Modos-Labs/Glider/assets/color_4bpp_ed.png

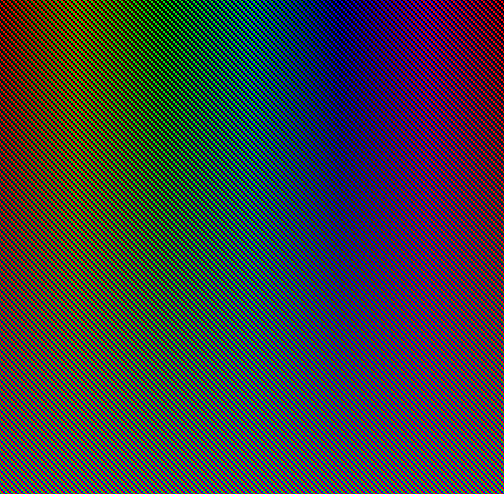
assets/color_4bpp_ed.png
