Modos-Labs/Glider/assets/color_8bpp.png

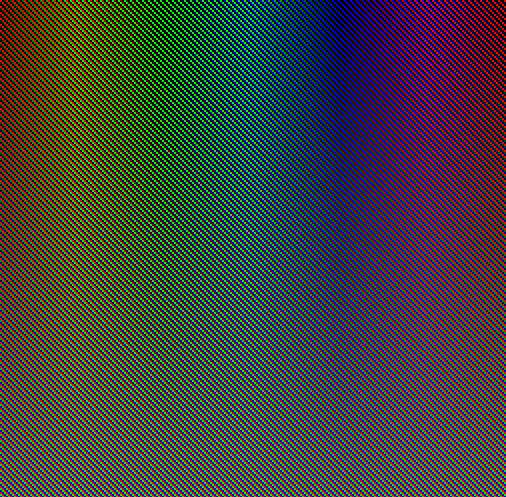
assets/color_8bpp.png
