Modos-Labs/Glider/assets/color_bayer.png

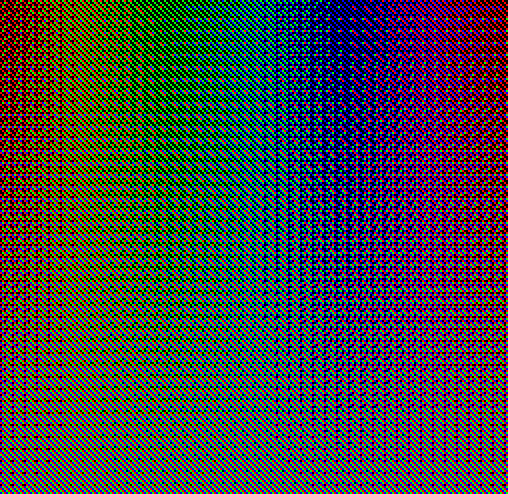
assets/color_bayer.png
