Modos-Labs/Glider/assets/color_des.jpg

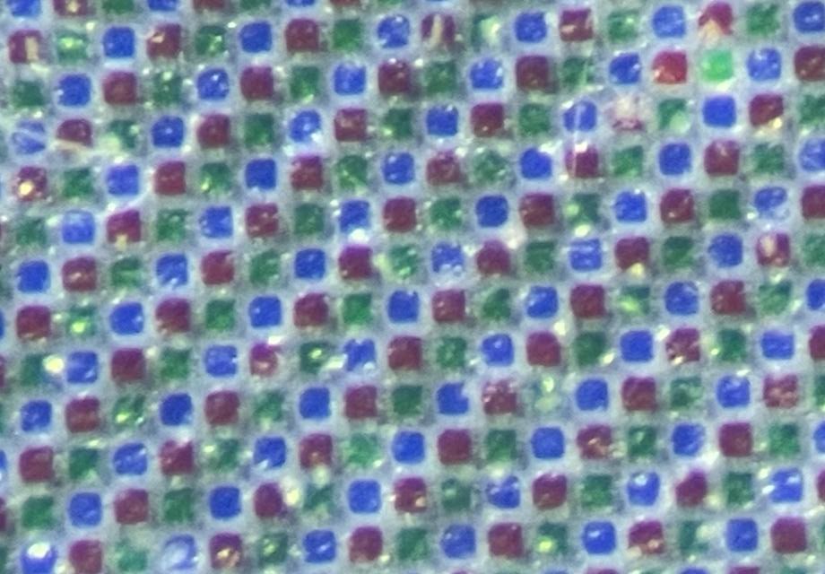
assets/color_des.jpg
