Modos-Labs/Glider/assets/color_fs_wrong.png

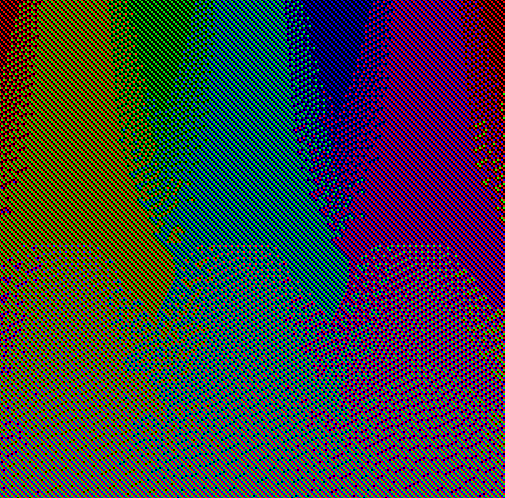
assets/color_fs_wrong.png
