Modos-Labs/Glider/assets/color_nd.png

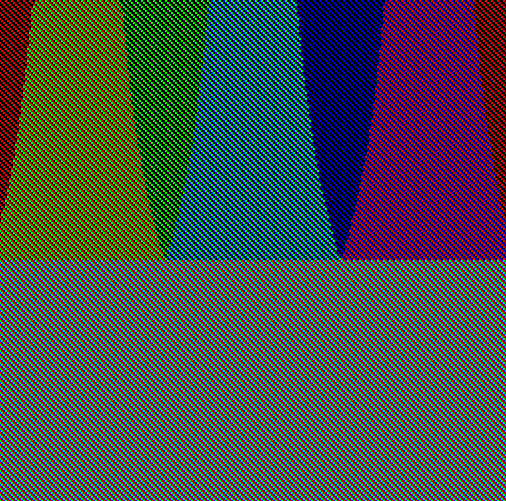
assets/color_nd.png
