Modos-Labs/Glider/assets/des_with_spr.png

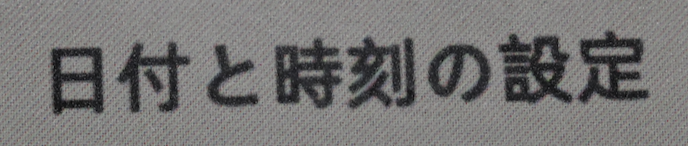
assets/des_with_spr.png
