Modos-Labs/Glider/assets/des_without_spr.png

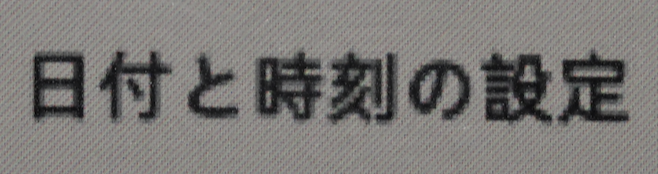
assets/des_without_spr.png
