Modos-Labs/Glider/assets/dither_gamma.jpg

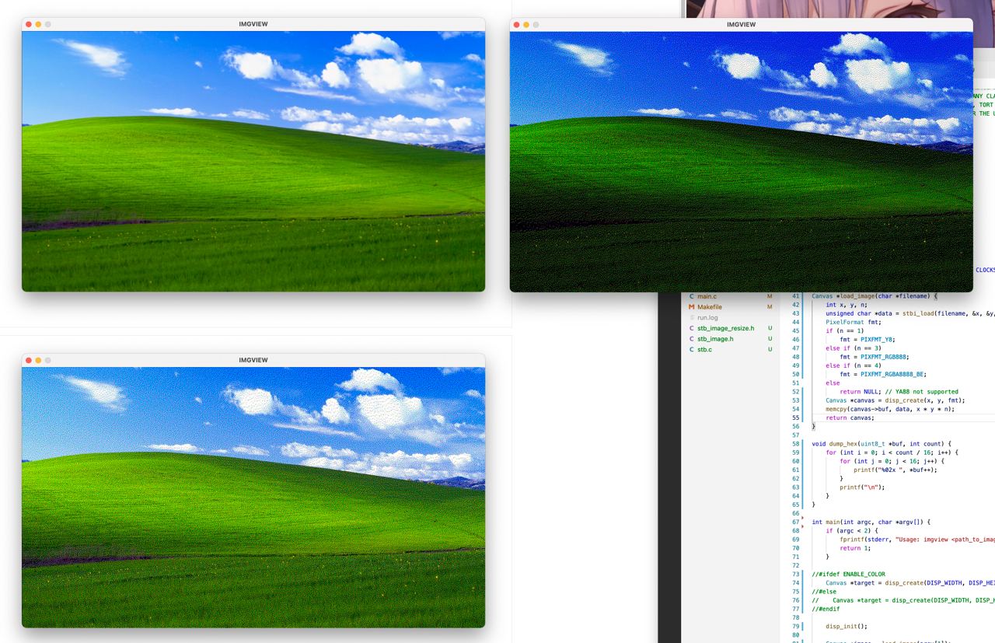
assets/dither_gamma.jpg
