Modos-Labs/Glider/assets/eink_16g.jpg

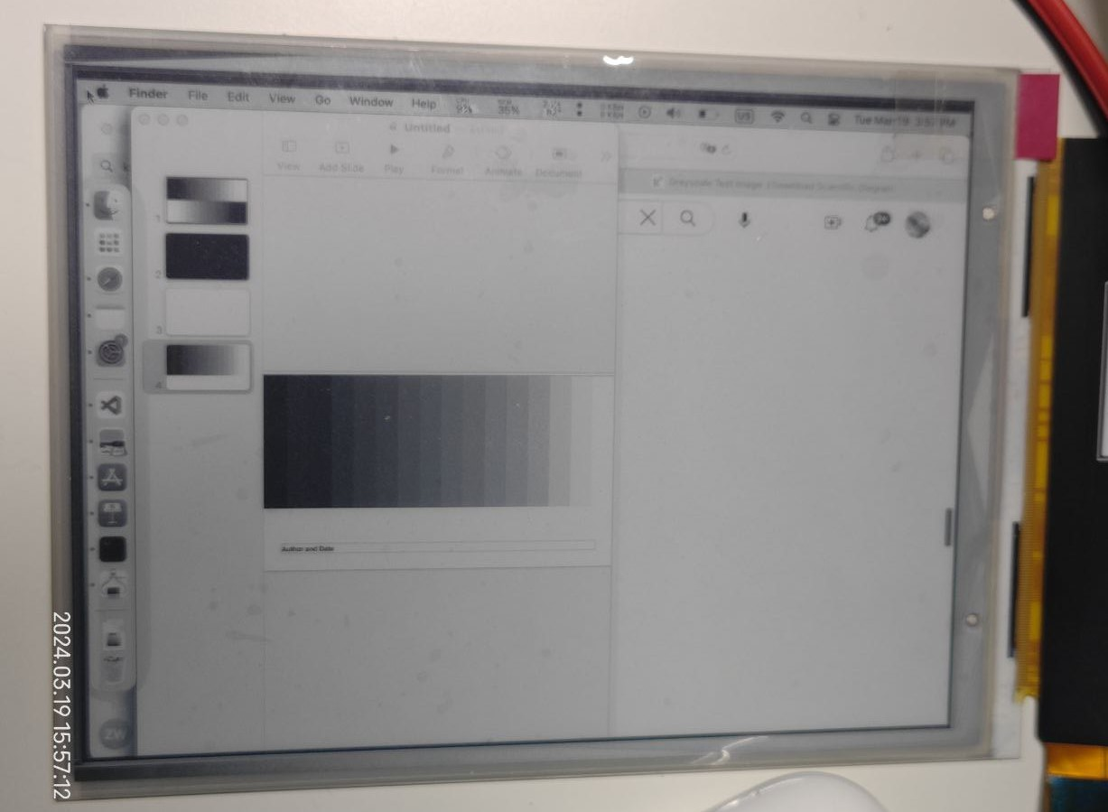
assets/eink_16g.jpg
