Modos-Labs/Glider/assets/eink_32g.jpg

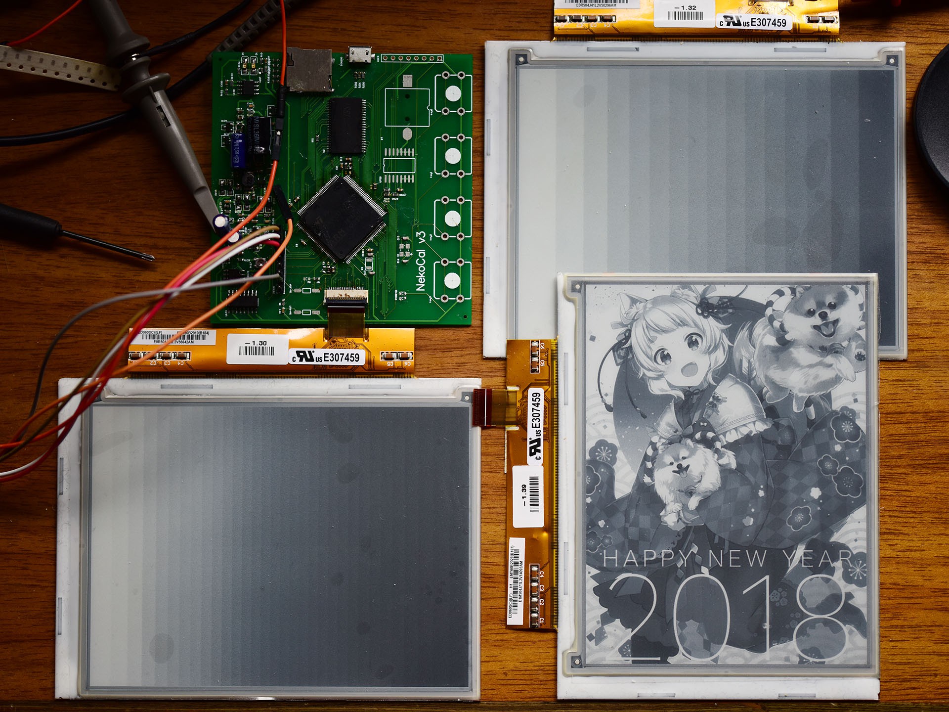
assets/eink_32g.jpg
