Modos-Labs/Glider/assets/eink_microscope.jpg

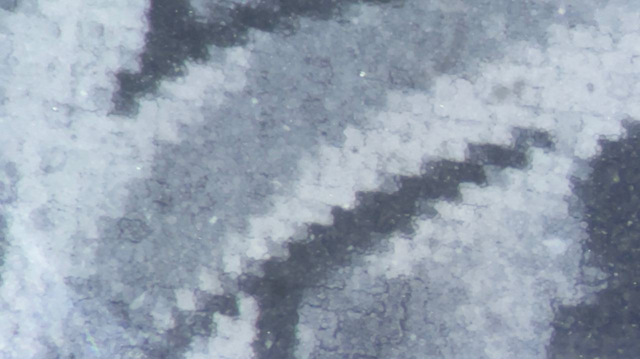
assets/eink_microscope.jpg
