Modos-Labs/Glider/assets/eink_serial.jpg

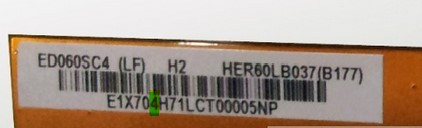
assets/eink_serial.jpg
