Modos-Labs/Glider/assets/eink_spectra6.jpg

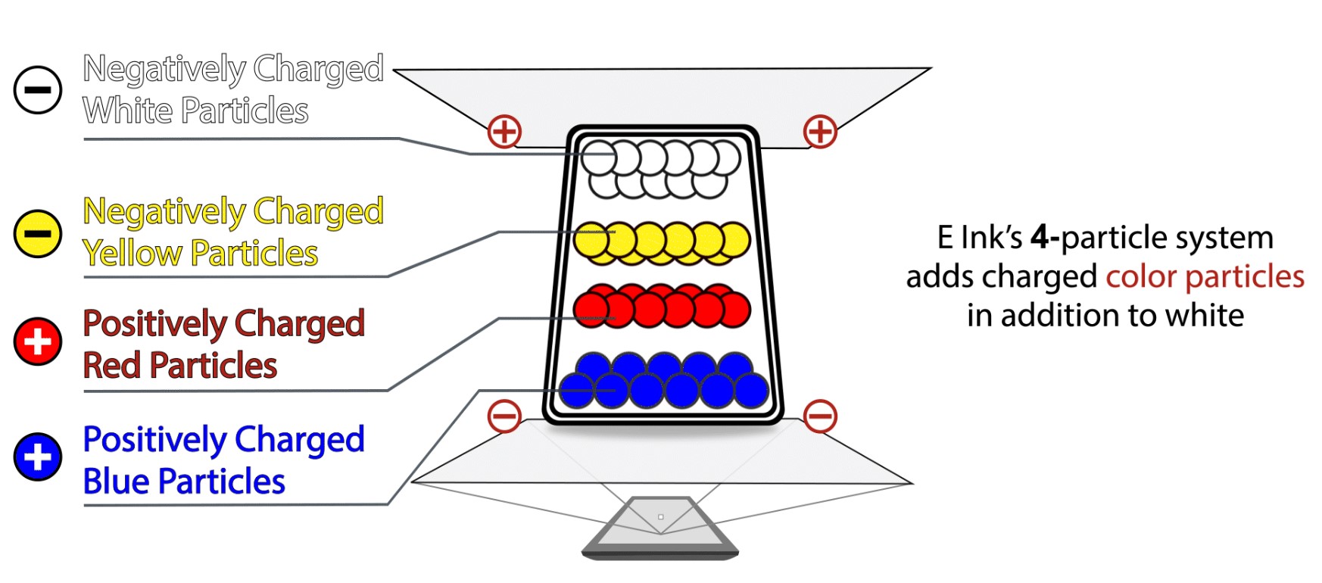
assets/eink_spectra6.jpg
