Modos-Labs/Glider/assets/gallery3_gallerypalette.jpg

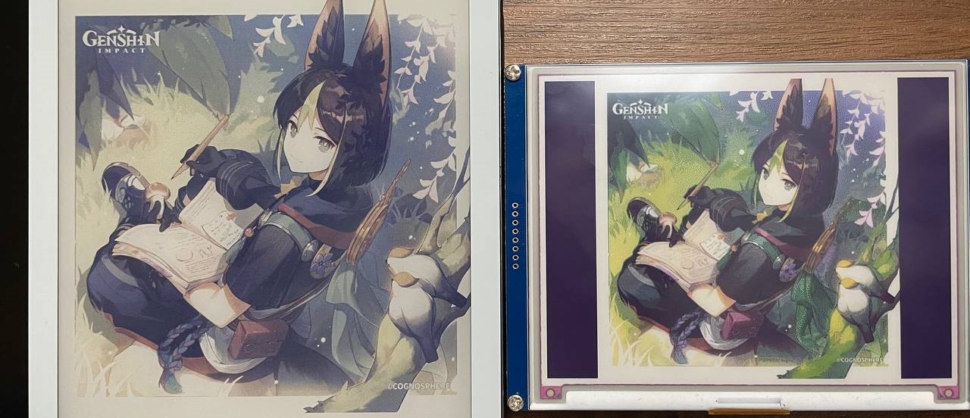
assets/gallery3_gallerypalette.jpg
