Modos-Labs/Glider/assets/gallery3_kaleido_plus.jpg

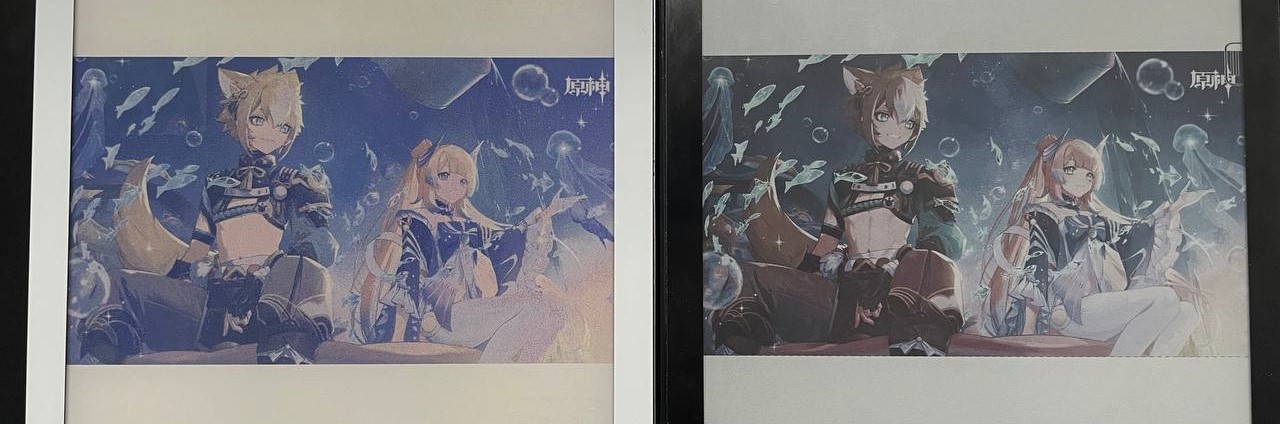
assets/gallery3_kaleido_plus.jpg
