Modos-Labs/Glider/assets/grad_4bpp_ed.png

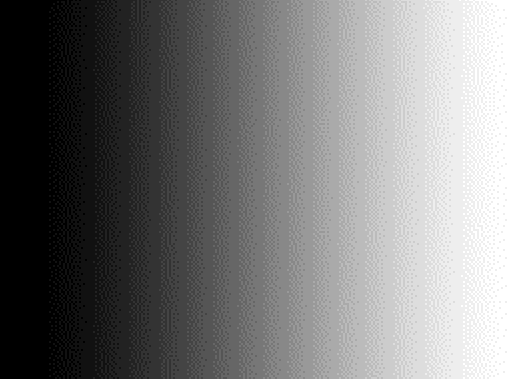
assets/grad_4bpp_ed.png
