Modos-Labs/Glider/assets/grad_no_dither.png

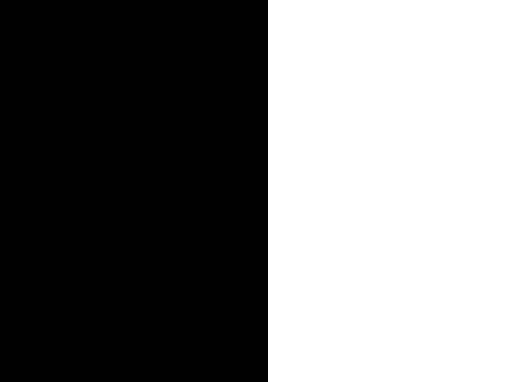
assets/grad_no_dither.png
