Modos-Labs/Glider/assets/hw_with_screen.jpg

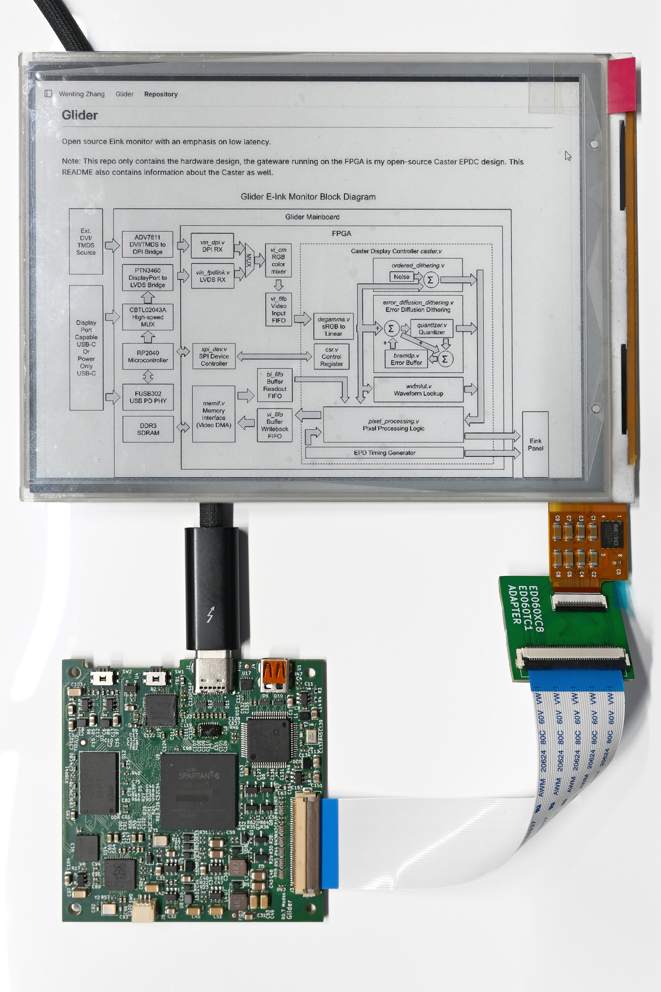
assets/hw_with_screen.jpg
