Modos-Labs/Glider/assets/isabella.jpg

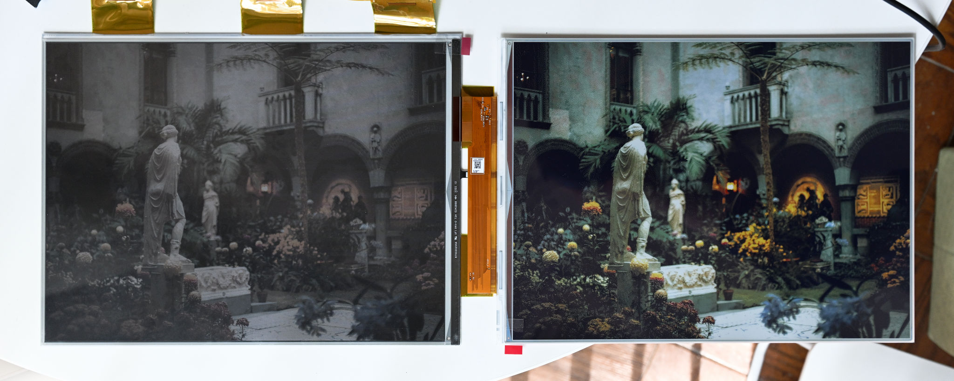
assets/isabella.jpg
