Modos-Labs/Glider/assets/kaleido3spectra6.jpg

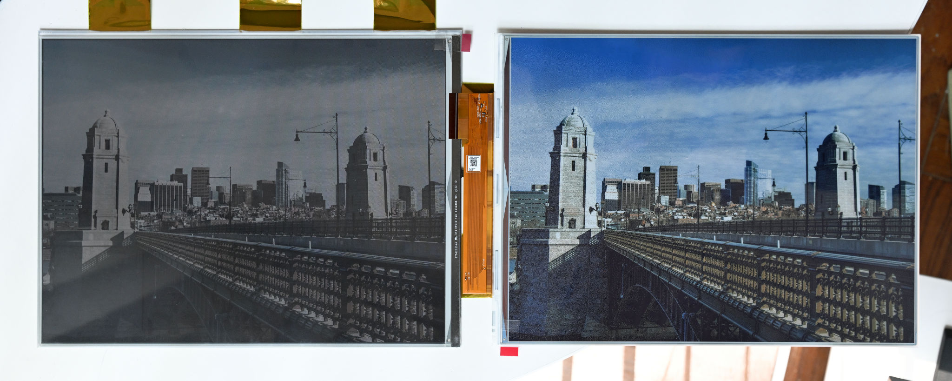
assets/kaleido3spectra6.jpg
