Modos-Labs/Glider/assets/PixelLayoutDiagonal.png

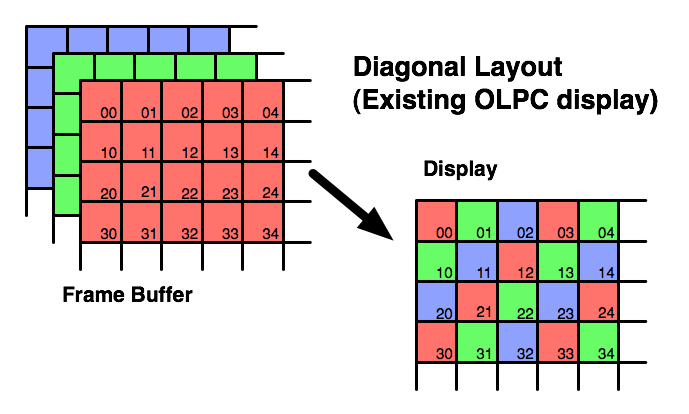
assets/PixelLayoutDiagonal.png
