Modos-Labs/Glider/assets/PixelProcDiagonal.png

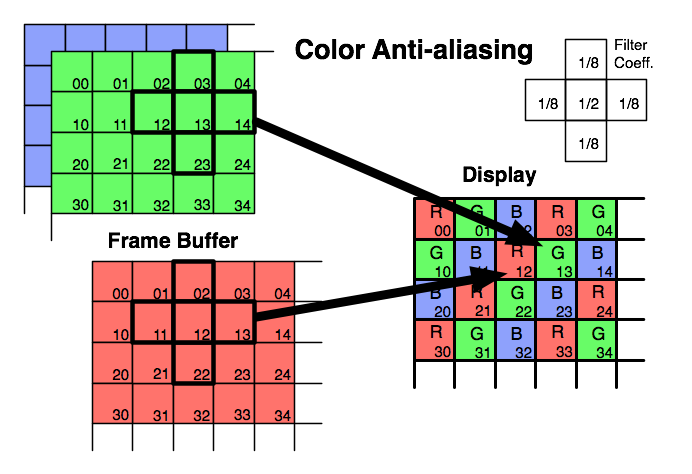
assets/PixelProcDiagonal.png
