Modos-Labs/Glider/assets/r0p7_mb.jpg

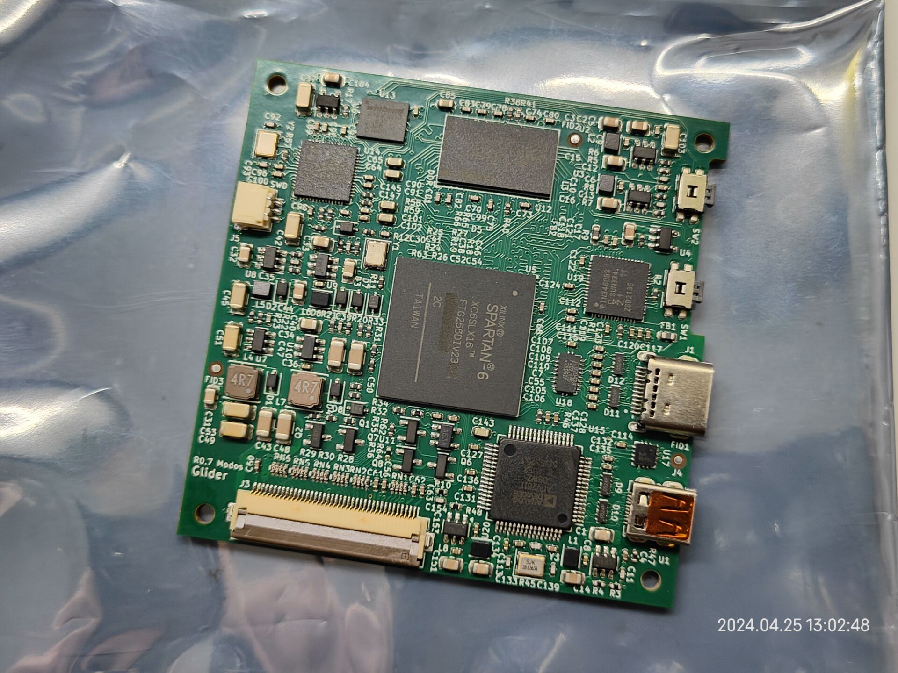
assets/r0p7_mb.jpg
