Modos-Labs/Glider/case/case.FCStd

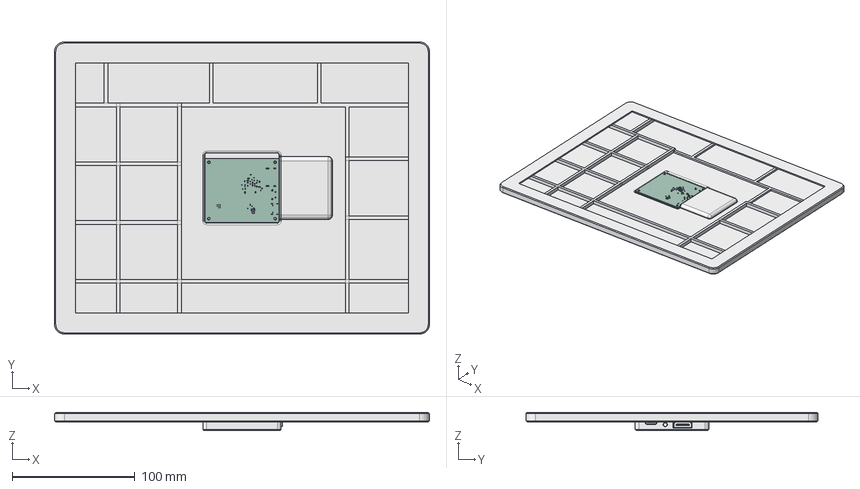
[picture p35: CAD file, 2024-01-24]
case/case.FCStd
306.0 x 238.4 x 15.0 mm
Front
Back
R_0402_1005Metric
R_0402_1005Metric002
R_0402_1005Metric004
C_0402_1005Metric
C_0402_1005Metric002
L_Wuerth_MAPI_2010
R_Array_Convex_4x0402
C_0402_1005Metric004
QFN-56-1EP_7x7mm_Pitch0.4mm
R_0402_1005Metric006
C_0805_2012Metric
L_Wuerth_MAPI_2011
TSOT_23_6
R_0402_1005Metric008
R_0402_1005Metric010
R_0402_1005Metric012
C_1206_3216Metric
C_1206_3216Metric002
C_0402_1005Metric006
C_0402_1005Metric008
C_0402_1005Metric010
C_0402_1005Metric012
C_0805_2012Metric002
C_0402_1005Metric014
C_0402_1005Metric016
R_0402_1005Metric014
C_0402_1005Metric018
SW_Tactile_SPST_Angled_PTS645Vx58-2LFS
WSON8-6x5
WSON8-6x006
WSON8-6x007
WSON8-6x008
WSON8-6x009
WSON8-6x010
WSON8-6x011
WSON8-6x012
WSON8-6x013
WSON8-6x014
D_SOD_323
C_0402_1005Metric020
SOT_23
C_0402_1005Metric022
R_0402_1005Metric016
C_0402_1005Metric024
D_SOD_324
C_0402_1005Metric026
R_0402_1005Metric018
L_Wuerth_MAPI_2012
C_0402_1005Metric028
C_0402_1005Metric030
C_0402_1005Metric032
C_0402_1005Metric034
SOT_024
TSOT_23_007
R_0402_1005Metric020
R_0402_1005Metric022
R_0402_1005Metric024
R_0402_1005Metric026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
