Modos-Labs/Glider/CHANGES.txt

The following are the changes for the hardware.

R0.1
1. Initial release.

R0.2
1. Switch from ECP5 to SPARTAN6 FPGA

R0.3
1. Remove on-board 39pin/ 50pin connector, switch to 40pin connector or EPD
2. Remove DSI input connector
3. Add DisplayPort to LVDS bridge chip and DisplayPort input

R0.4
1. Use Type-C input instead of full-size DisplayPort port

R0.5
1. Switch from MAX17135 PMIC to TPS65185 PMIC
2. Switch to a different TypeC connector model
3. Added global current limit

R0.6
1. Switch to individual DCDCs for Eink power supply

Lite R0.1
1. Use DVI TMDS input in place of Type-C input and DP bridge
2. Use DCDC instead of charge pump + zener diode for lower Iq
3. Add user button
4. Add VCOM measure capability
5. Add RP2040 SWD connector

R0.7
1. Import DVI TMDS input, newly revised power supply and user button from RL0.1
2. Connect FPGA to RP2040's hardware SPI
3. Fix USB Type C mux connection

R0.8
1. Fix DVI TMDS connector pinout
2. Add FL connector

R0.9
1. Switch to 7-series FPGA
2. New 50P connector for EPD
3. Add voltage/ current monitoring for the screen and the FPGA
4. Use FFC for FL connector
5. Add jumper for RP2040 ISP
6. Add shield

R0.10
1. Switch back to 6-series FPGA
2. Switch to use STM32H750 as EC

R0.11
1. Fix main DCDC feedback resistors
2. Adjust pinout assignment for EPD again

R0.12
1. Fix buttons
2. Fix DVI HPD connection

R0.13
1. Add user GPIOs
2. Use a lower profile USB receptacle

R1.0
1. Replace LGS5148 with LGS5145

R1.1
1. Fix DVI HPD glitch

R1.2
1. Add additional power switches for positive rails
2. Add additional decap for VCOM measurement
