Modos-Labs/Glider/pcb/mega_adapter/adapter.kicad_pcb

## KiCad design pcb/mega_adapter/adapter.kicad_pcb (2025-08-06)

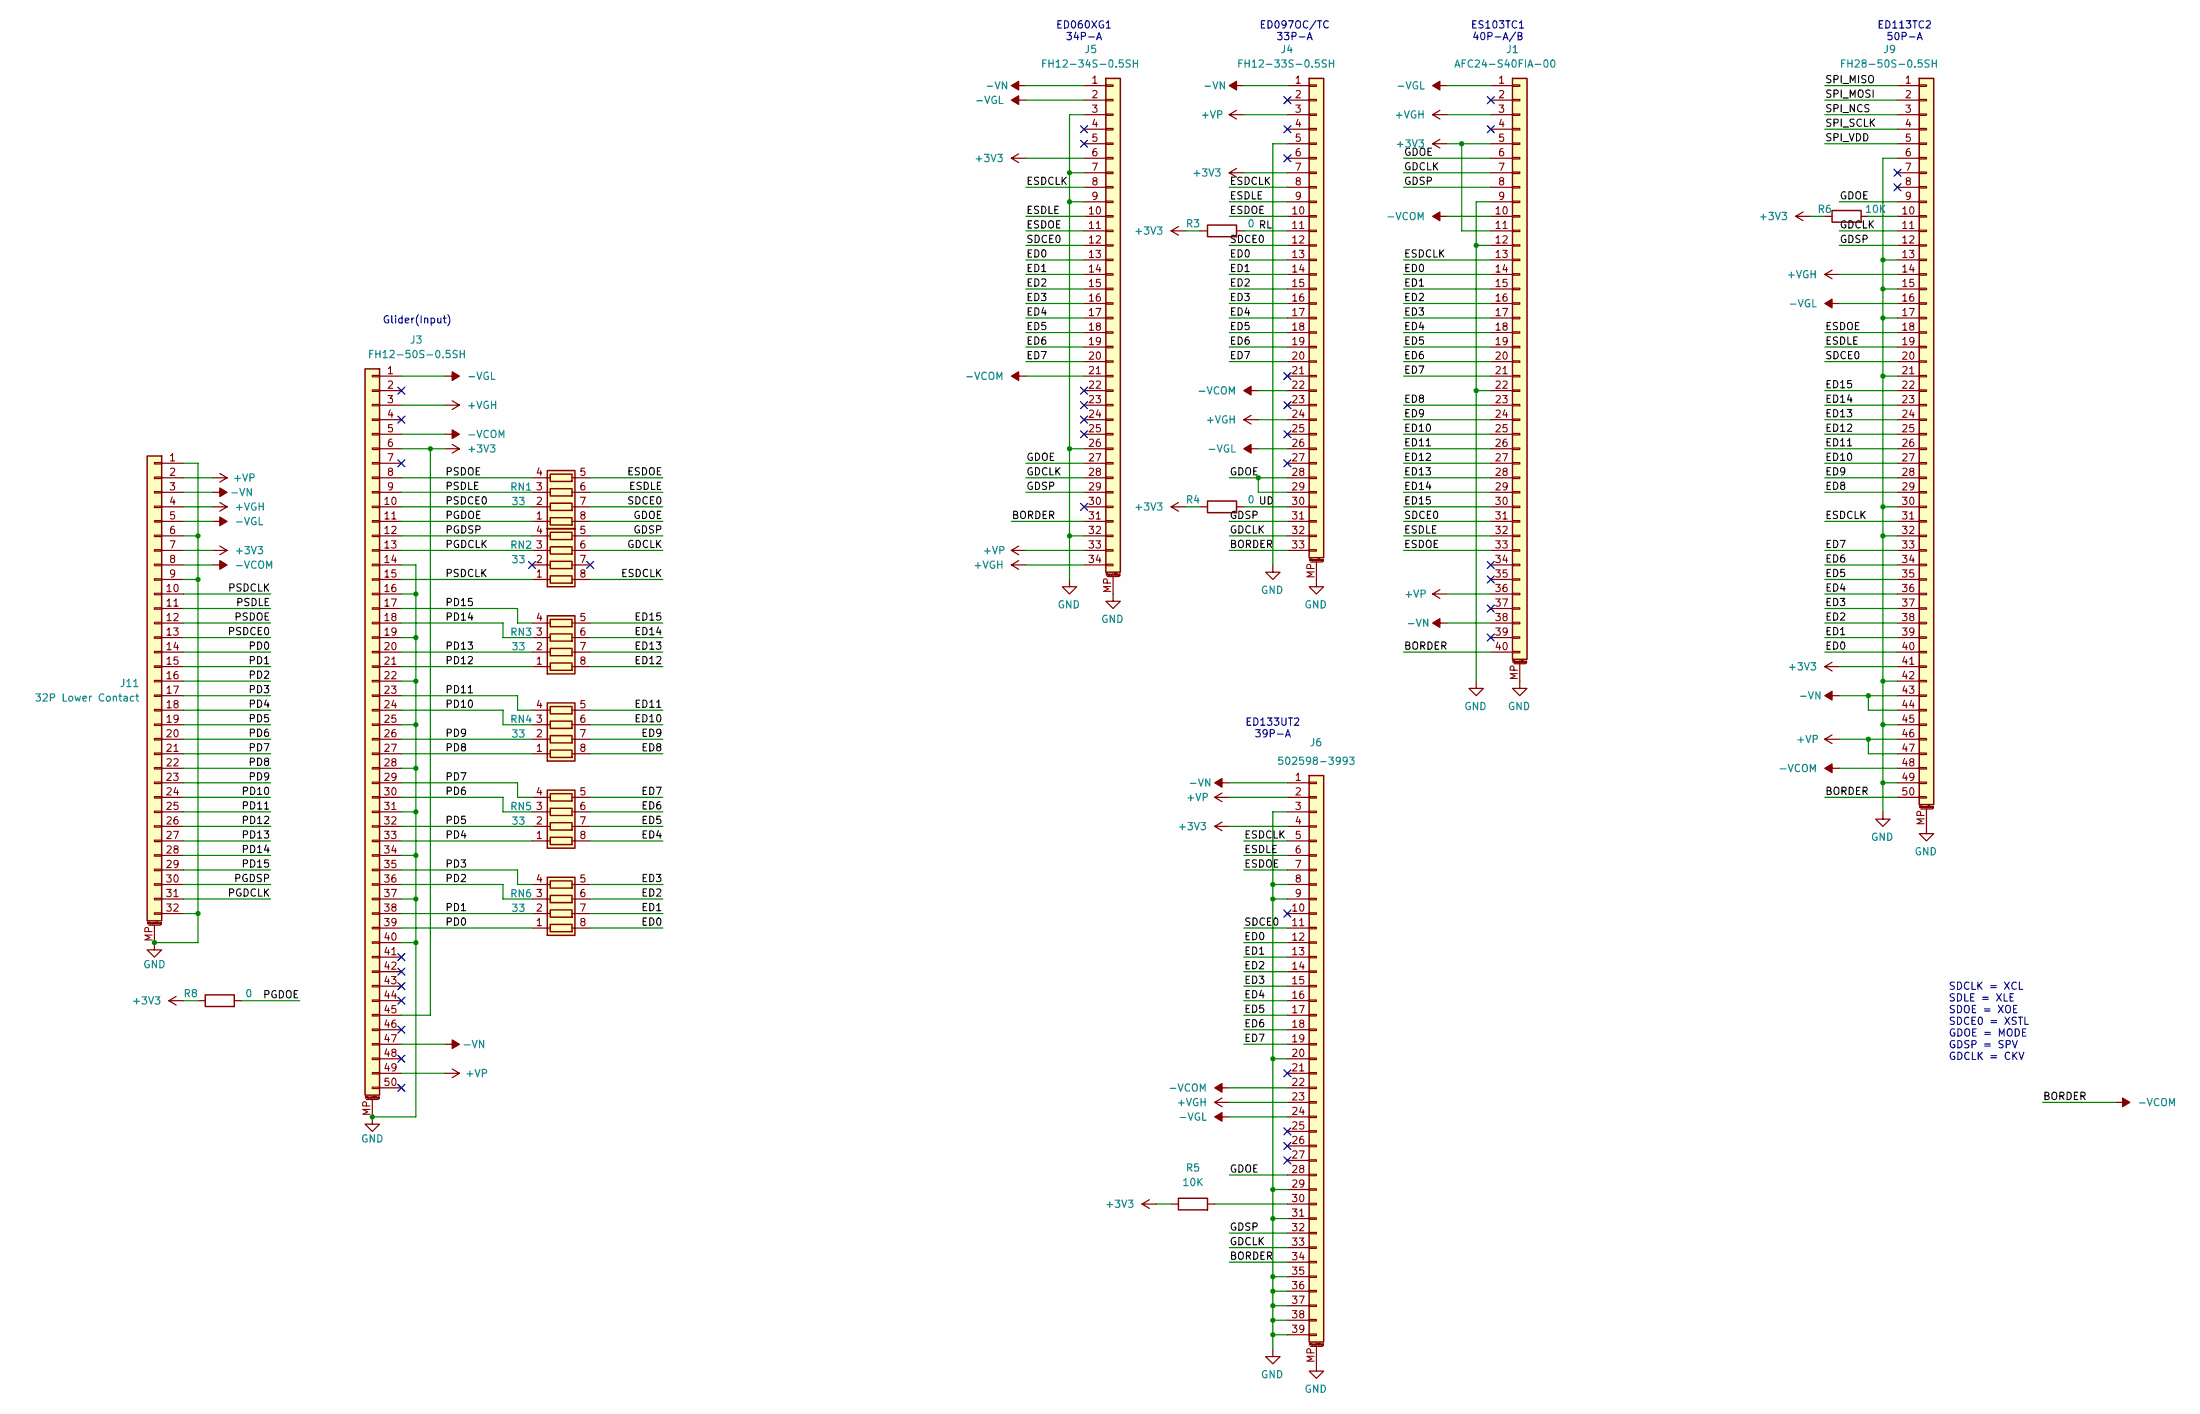
[picture p36: schematic adapter.kicad_sch]

Parts:
J1: AFC24-S40FIA-00; Omron_XF2M-4015-1A_1x40-1MP_P0.5mm_Horizontal
J3: FH12-50S-0.5SH; Hirose_FH12-50S-0.5SH_1x50-1MP_P0.50mm_Horizontal_Mirrored
J4: FH12-33S-0.5SH; Hirose_FH12-33S-0.5SH_1x33-1MP_P0.50mm_Horizontal
J5: FH12-34S-0.5SH; Hirose_FH12-34S-0.5SH_1x34-1MP_P0.50mm_Horizontal
J6: 502598-3993; Molex_5025983993; LCSC 609-10064555-392120HLFCT-ND
J9: FH28-50S-0.5SH; Hirose_FH12-50S-0.5SH_1x50-1MP_P0.50mm_Horizontal
J11: 32P Lower Contact; Hirose_FH12-32S-0.5SH_1x32-1MP_P0.50mm_Horizontal_Mirrored
R3, R4, R8: 0; R_0402_1005Metric
R5, R6: 10K; R_0402_1005Metric
RN1, RN2, RN3, RN4, RN5, RN6: 33; R_Array_Convex_4x0402

Connections:
+3V3: J1.5, J1.11, J3.6, J3.45, J4.7, J5.6, J6.4, J9.41, J11.7, R3.1, R4.1, R5.1, R6.1, R8.1
+VGH: J1.3, J3.3, J4.24, J5.34, J6.23, J9.14, J11.4
+VP: J1.36, J3.49, J4.3, J5.33, J6.2, J9.46, J9.47, J11.2
-VCOM: J1.10, J1.40, J3.5, J4.22, J4.33, J5.21, J5.31, J6.22, J6.34, J9.48, J9.50, J11.8
-VGL: J1.1, J3.1, J4.26, J5.2, J6.24, J9.16, J11.5
-VN: J1.38, J3.47, J4.1, J5.1, J6.1, J9.43, J9.44, J11.3
/ED0: J1.14, J4.13, J5.13, J6.12, J9.40, RN6.8 (R1.2)
/ED1: J1.15, J4.14, J5.14, J6.13, J9.39, RN6.7 (R2.2)
/ED2: J1.16, J4.15, J5.15, J6.14, J9.38, RN6.6 (R3.2)
/ED3: J1.17, J4.16, J5.16, J6.15, J9.37, RN6.5 (R4.2)
/ED4: J1.18, J4.17, J5.17, J6.16, J9.36, RN5.8 (R1.2)
/ED5: J1.19, J4.18, J5.18, J6.17, J9.35, RN5.7 (R2.2)
/ED6: J1.20, J4.19, J5.19, J6.18, J9.34, RN5.6 (R3.2)
/ED7: J1.21, J4.20, J5.20, J6.19, J9.33, RN5.5 (R4.2)
/ED8: J1.23, J9.29, RN4.8 (R1.2)
/ED9: J1.24, J9.28, RN4.7 (R2.2)
/ED10: J1.25, J9.27, RN4.6 (R3.2)
/ED11: J1.26, J9.26, RN4.5 (R4.2)
/ED12: J1.27, J9.25, RN3.8 (R1.2)
/ED13: J1.28, J9.24, RN3.7 (R2.2)
/ED14: J1.29, J9.23, RN3.6 (R3.2)
/ED15: J1.30, J9.22, RN3.5 (R4.2)
/ESDCLK: J1.13, J4.8, J5.8, J6.5, J9.31, RN2.8 (R1.2)
/ESDLE: J1.32, J4.9, J5.10, J6.6, J9.19, RN1.6 (R3.2)
/ESDOE: J1.33, J4.10, J5.11, J6.7, J9.18, RN1.5 (R4.2)
/GDCLK: J1.7, J4.32, J5.28, J6.33, J9.11, RN2.6 (R3.2)
/GDOE: J1.6, J4.28, J4.29, J5.27, J6.28, J9.9, RN1.8 (R1.2)
/GDSP: J1.8, J4.31, J5.29, J6.32, J9.12, RN2.5 (R4.2)
/PD0: J3.39, J11.14, RN6.1 (R1.1)
/PD1: J3.38, J11.15, RN6.2 (R2.1)
/PD2: J3.36, J11.16, RN6.3 (R3.1)
/PD3: J3.35, J11.17, RN6.4 (R4.1)
/PD4: J3.33, J11.18, RN5.1 (R1.1)
/PD5: J3.32, J11.19, RN5.2 (R2.1)
/PD6: J3.30, J11.20, RN5.3 (R3.1)
/PD7: J3.29, J11.21, RN5.4 (R4.1)
/PD8: J3.27, J11.22, RN4.1 (R1.1)
/PD9: J3.26, J11.23, RN4.2 (R2.1)
/PD10: J3.24, J11.24, RN4.3 (R3.1)
/PD11: J3.23, J11.25, RN4.4 (R4.1)
/PD12: J3.21, J11.26, RN3.1 (R1.1)
/PD13: J3.20, J11.27, RN3.2 (R2.1)
/PD14: J3.18, J11.28, RN3.3 (R3.1)
/PD15: J3.17, J11.29, RN3.4 (R4.1)
/PGDCLK: J3.13, J11.31, RN2.3 (R3.1)
/PGDOE: J3.11, R8.2, RN1.1 (R1.1)
/PGDSP: J3.12, J11.30, RN2.4 (R4.1)
/PSDCE0: J3.10, J11.13, RN1.2 (R2.1)
/PSDCLK: J3.15, J11.10, RN2.1 (R1.1)
/PSDLE: J3.9, J11.11, RN1.3 (R3.1)
/PSDOE: J3.8, J11.12, RN1.4 (R4.1)
/RL: J4.11, R3.2
/SDCE0: J1.31, J4.12, J5.12, J6.11, J9.20, RN1.7 (R2.2)
/SPI_MISO: J9.1
/SPI_MOSI: J9.2
/SPI_NCS: J9.3
/SPI_SCLK: J9.4
/SPI_VDD: J9.5
/UD: J4.30, R4.2
GND: J1.9, J1.12, J1.22, J1.MP (MountPin), J3.14, J3.16, J3.19, J3.22, J3.25, J3.28, J3.31, J3.34, J3.37, J3.40, J3.MP (MountPin), J4.5, J4.MP (MountPin), J5.3, J5.7, J5.9, J5.26, J5.32, J5.MP (MountPin), J6.3, J6.8, J6.9, J6.20, J6.29, J6.31, J6.35, J6.36, J6.37, J6.38, J6.39, J6.MP (MountPin), J9.6, J9.13, J9.15, J9.17, J9.21, J9.30, J9.32, J9.42, J9.45, J9.49, J9.MP (MountPin), J11.1, J11.6, J11.9, J11.32, J11.MP (MountPin)
unnamed: J6.30, R5.2
unnamed: J9.10, R6.2

Notes on the sheet:
ED133UT2 39P-A
ED060XG1 34P-A
ED113TC2 50P-A
Glider(Input)
ES103TC1 40P-A/B
ED097OC/TC 33P-A
SDCLK = XCL SDLE = XLE SDOE = XOE SDCE0 = XSTL GDOE = MODE GDSP = SPV GDCLK = CKV

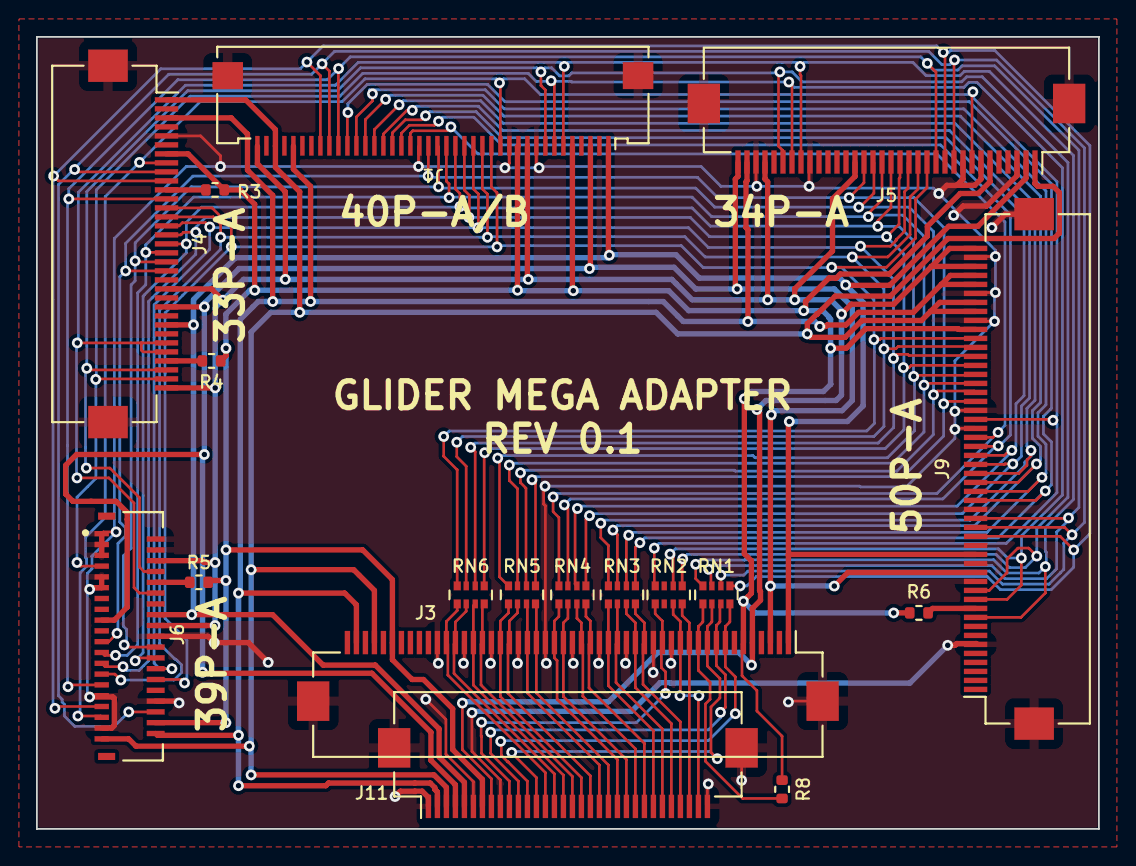
[picture p37: board pcb/mega_adapter/adapter.kicad_pcb from above]

Board: 2 copper layers, 59.0 x 44.0 mm, 18 parts (0 on the bottom side), 57 nets.
