Modos-Labs/Glider/pcb/34p-adapter-a/adapter.kicad_pcb

## KiCad design pcb/34p-adapter-a/adapter.kicad_pcb (2025-08-06)

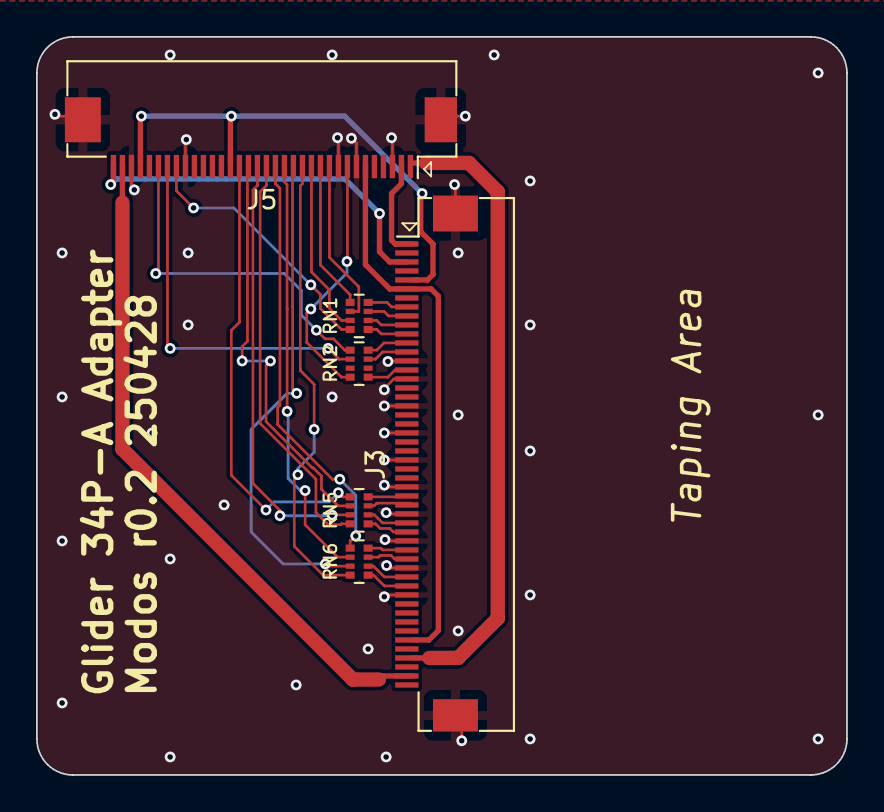
[picture p38: board pcb/34p-adapter-a/adapter.kicad_pcb from above]

Board: 2 copper layers, 45.0 x 41.0 mm, 6 parts (0 on the bottom side), 37 nets.

Parts:
J3: FH12-50S-0.5SH; Xunpu_FPC-05F-50PH20_1x50-1MP_P0.50mm_Horizontal_Mirrored
J5: FH12-34S-0.5SH; Xunpu_FPC-05F-34PH20_1x34-1MP_P0.50mm_Horizontal
RN1, RN2, RN5, RN6: 33; R_Array_Convex_4x0402

Connections:
+3V3: J3.6, J3.45, J5.6
+VGH: J3.3, J5.34
+VP: J3.49, J5.33
-VCOM: J3.5, J5.21, J5.31
-VGL: J3.1, J5.2
-VN: J3.47, J5.1
/ED0: J5.13, RN6.8 (R1.2)
/ED1: J5.14, RN6.7 (R2.2)
/ED2: J5.15, RN6.6 (R3.2)
/ED3: J5.16, RN6.5 (R4.2)
/ED4: J5.17, RN5.8 (R1.2)
/ED5: J5.18, RN5.7 (R2.2)
/ED6: J5.19, RN5.6 (R3.2)
/ED7: J5.20, RN5.5 (R4.2)
/ESDCLK: J5.8, RN2.8 (R1.2)
/ESDLE: J5.10, RN1.6 (R3.2)
/ESDOE: J5.11, RN1.5 (R4.2)
/GDCLK: J5.28, RN2.6 (R3.2)
/GDOE: J5.27, RN1.8 (R1.2)
/GDSP: J5.29, RN2.5 (R4.2)
/PD0: J3.39, RN6.1 (R1.1)
/PD1: J3.38, RN6.2 (R2.1)
/PD2: J3.36, RN6.3 (R3.1)
/PD3: J3.35, RN6.4 (R4.1)
/PD4: J3.33, RN5.1 (R1.1)
/PD5: J3.32, RN5.2 (R2.1)
/PD6: J3.30, RN5.3 (R3.1)
/PD7: J3.29, RN5.4 (R4.1)
/PGDCLK: J3.13, RN2.3 (R3.1)
/PGDOE: J3.11, RN1.1 (R1.1)
/PGDSP: J3.12, RN2.4 (R4.1)
/PSDCE0: J3.10, RN1.2 (R2.1)
/PSDCLK: J3.15, RN2.1 (R1.1)
/PSDLE: J3.9, RN1.3 (R3.1)
/PSDOE: J3.8, RN1.4 (R4.1)
/SDCE0: J5.12, RN1.7 (R2.2)
GND: J3.14, J3.16, J3.19, J3.22, J3.25, J3.28, J3.31, J3.34, J3.37, J3.40, J3.MP (MountPin), J5.3, J5.7, J5.9, J5.26, J5.32, J5.MP (MountPin)
