Modos-Labs/Glider/pcb/40p-adapter-ab/adapter.kicad_pcb

## KiCad design pcb/40p-adapter-ab/adapter.kicad_pcb (2025-08-06)

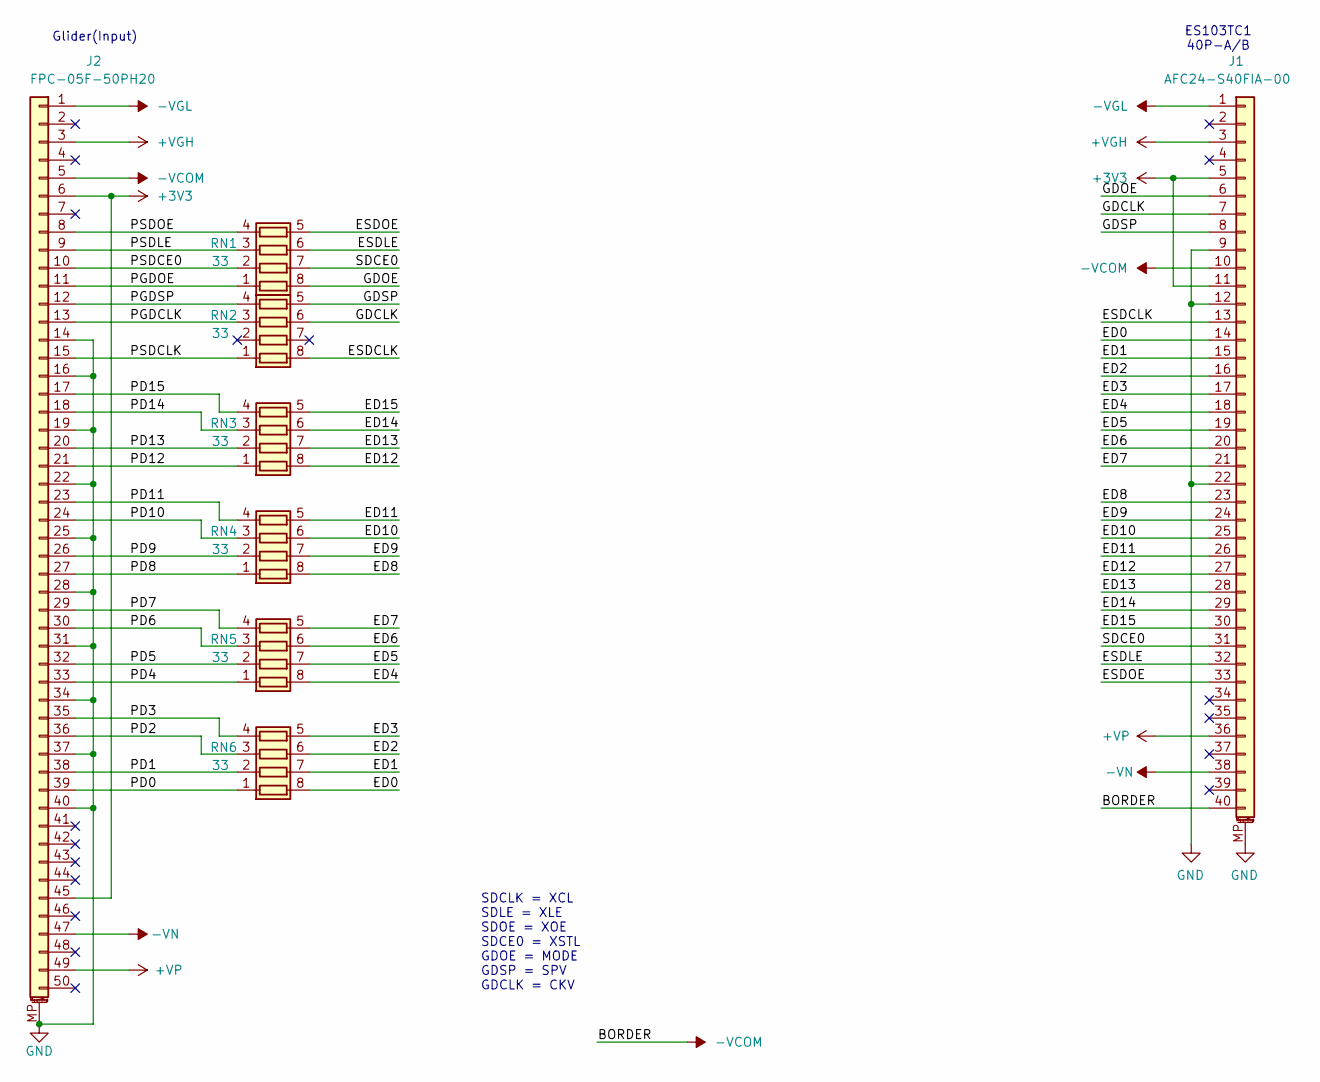
[picture p39: schematic adapter.kicad_sch]

Parts:
J1: AFC24-S40FIA-00; Omron_XF2M-4015-1A_1x40-1MP_P0.5mm_Horizontal
J2: FPC-05F-50PH20; Xunpu_FPC-05F-50PH20_1x50-1MP_P0.50mm_Horizontal_Mirrored
RN1, RN2, RN3, RN4, RN5, RN6: 33; R_Array_Convex_4x0402

Connections:
+3V3: J1.5, J1.11, J2.6, J2.45
+VGH: J1.3, J2.3
+VP: J1.36, J2.49
-VCOM: J1.10, J1.40, J2.5
-VGL: J1.1, J2.1
-VN: J1.38, J2.47
/ED0: J1.14, RN6.8 (R1.2)
/ED1: J1.15, RN6.7 (R2.2)
/ED2: J1.16, RN6.6 (R3.2)
/ED3: J1.17, RN6.5 (R4.2)
/ED4: J1.18, RN5.8 (R1.2)
/ED5: J1.19, RN5.7 (R2.2)
/ED6: J1.20, RN5.6 (R3.2)
/ED7: J1.21, RN5.5 (R4.2)
/ED8: J1.23, RN4.8 (R1.2)
/ED9: J1.24, RN4.7 (R2.2)
/ED10: J1.25, RN4.6 (R3.2)
/ED11: J1.26, RN4.5 (R4.2)
/ED12: J1.27, RN3.8 (R1.2)
/ED13: J1.28, RN3.7 (R2.2)
/ED14: J1.29, RN3.6 (R3.2)
/ED15: J1.30, RN3.5 (R4.2)
/ESDCLK: J1.13, RN2.8 (R1.2)
/ESDLE: J1.32, RN1.6 (R3.2)
/ESDOE: J1.33, RN1.5 (R4.2)
/GDCLK: J1.7, RN2.6 (R3.2)
/GDOE: J1.6, RN1.8 (R1.2)
/GDSP: J1.8, RN2.5 (R4.2)
/PD0: J2.39, RN6.1 (R1.1)
/PD1: J2.38, RN6.2 (R2.1)
/PD2: J2.36, RN6.3 (R3.1)
/PD3: J2.35, RN6.4 (R4.1)
/PD4: J2.33, RN5.1 (R1.1)
/PD5: J2.32, RN5.2 (R2.1)
/PD6: J2.30, RN5.3 (R3.1)
/PD7: J2.29, RN5.4 (R4.1)
/PD8: J2.27, RN4.1 (R1.1)
/PD9: J2.26, RN4.2 (R2.1)
/PD10: J2.24, RN4.3 (R3.1)
/PD11: J2.23, RN4.4 (R4.1)
/PD12: J2.21, RN3.1 (R1.1)
/PD13: J2.20, RN3.2 (R2.1)
/PD14: J2.18, RN3.3 (R3.1)
/PD15: J2.17, RN3.4 (R4.1)
/PGDCLK: J2.13, RN2.3 (R3.1)
/PGDOE: J2.11, RN1.1 (R1.1)
/PGDSP: J2.12, RN2.4 (R4.1)
/PSDCE0: J2.10, RN1.2 (R2.1)
/PSDCLK: J2.15, RN2.1 (R1.1)
/PSDLE: J2.9, RN1.3 (R3.1)
/PSDOE: J2.8, RN1.4 (R4.1)
/SDCE0: J1.31, RN1.7 (R2.2)
GND: J1.9, J1.12, J1.22, J1.MP (MountPin), J2.14, J2.16, J2.19, J2.22, J2.25, J2.28, J2.31, J2.34, J2.37, J2.40, J2.MP (MountPin)

Notes on the sheet:
Glider(Input)
ES103TC1 40P-A/B
SDCLK = XCL SDLE = XLE SDOE = XOE SDCE0 = XSTL GDOE = MODE GDSP = SPV GDCLK = CKV

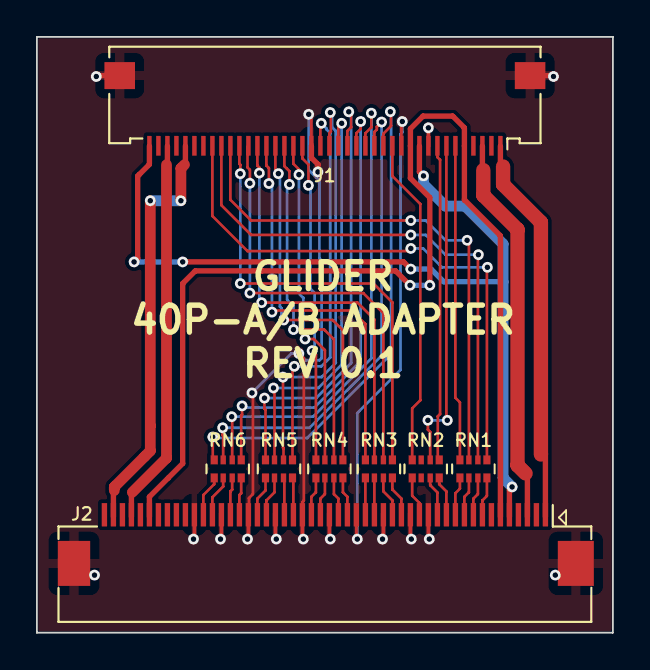
[picture p40: board pcb/40p-adapter-ab/adapter.kicad_pcb from above]

Board: 2 copper layers, 32.0 x 33.1 mm, 8 parts (0 on the bottom side), 53 nets.
