Modos-Labs/Glider/pcb/u133_adapter/adapter.kicad_pcb

## KiCad design pcb/u133_adapter/adapter.kicad_pcb (2025-07-13, an earlier design)

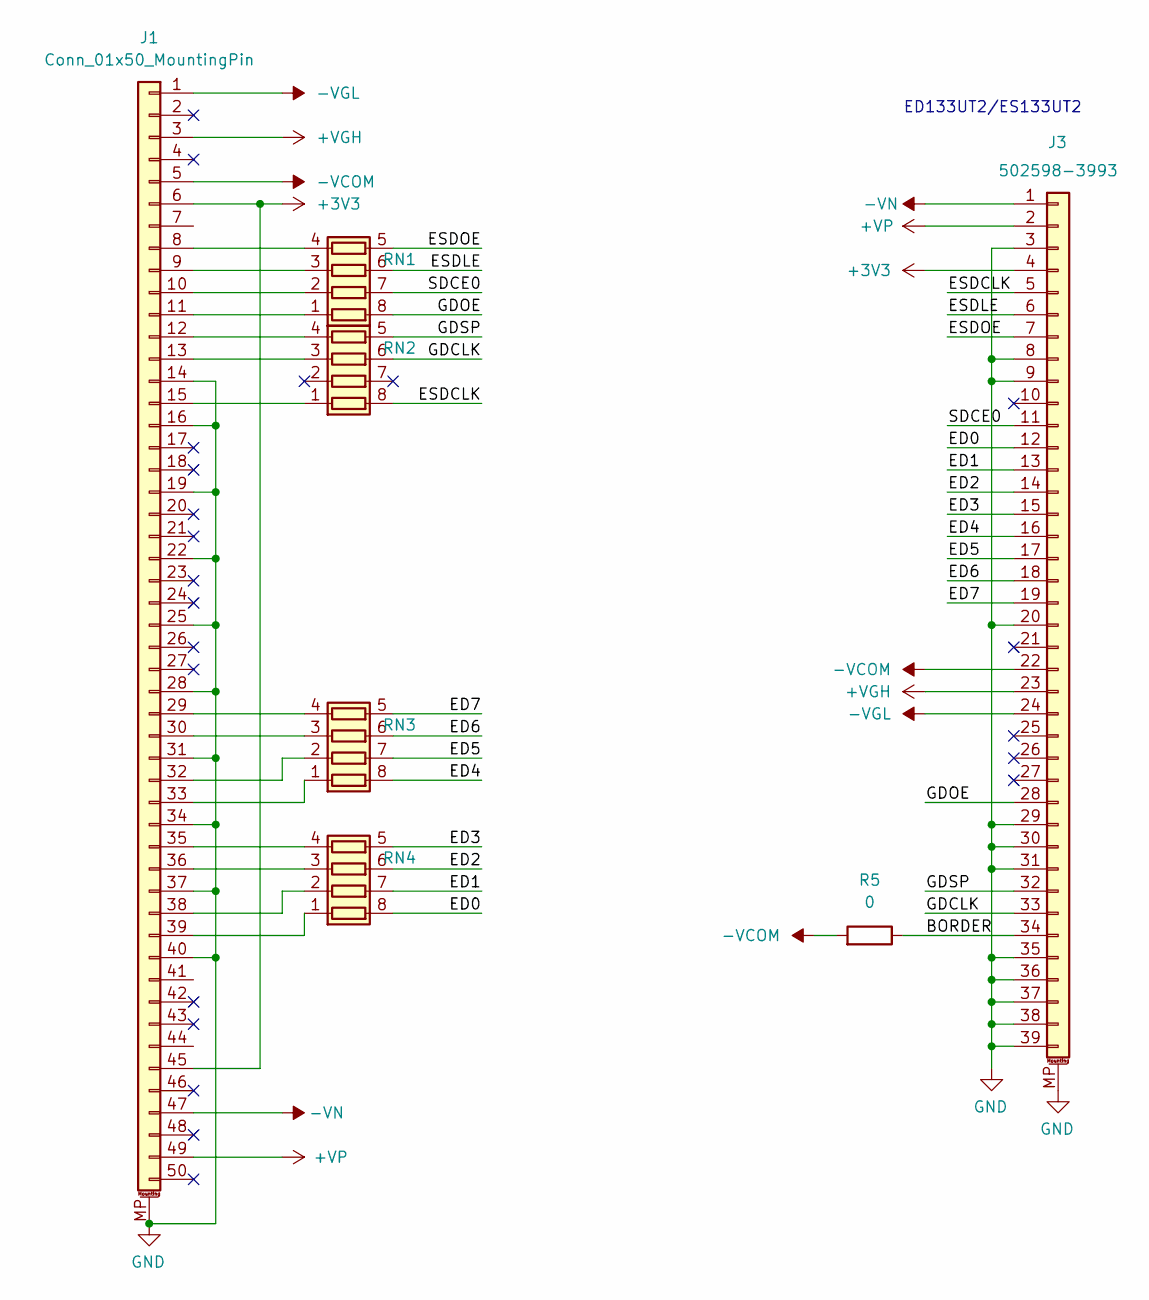
[picture p41: schematic adapter.kicad_sch, u133_support]

Parts:
J1: Conn_01x50_MountingPin; Xunpu_FPC-05F-50PH20_1x50-1MP_P0.50mm_Horizontal_Mirrored
J3: 502598-3993; Molex_5025983993; LCSC 609-10064555-392120HLFCT-ND
R5: 0; R_0402_1005Metric
RN1, RN2, RN3, RN4: 33R / 4D02WGF330JTCE; R_Array_Convex_4x0402

Connections:
+3V3: J1.6, J1.45, J3.4
+VGH: J1.3, J3.23
+VP: J1.49, J3.2
-VCOM: J1.5, J3.22, R5.2
-VGL: J1.1, J3.24
-VN: J1.47, J3.1
/BORDER: J3.34, R5.1
/ED0: J3.12, RN4.8 (R1.2)
/ED1: J3.13, RN4.7 (R2.2)
/ED2: J3.14, RN4.6 (R3.2)
/ED3: J3.15, RN4.5 (R4.2)
/ED4: J3.16, RN3.8 (R1.2)
/ED5: J3.17, RN3.7 (R2.2)
/ED6: J3.18, RN3.6 (R3.2)
/ED7: J3.19, RN3.5 (R4.2)
/ESDCLK: J3.5, RN2.8 (R1.2)
/ESDLE: J3.6, RN1.6 (R3.2)
/ESDOE: J3.7, RN1.5 (R4.2)
/GDCLK: J3.33, RN2.6 (R3.2)
/GDOE: J3.28, RN1.8 (R1.2)
/GDSP: J3.32, RN2.5 (R4.2)
/SDCE0: J3.11, RN1.7 (R2.2)
GND: J1.14, J1.16, J1.19, J1.22, J1.25, J1.28, J1.31, J1.34, J1.37, J1.40, J1.MP (MountPin), J3.3, J3.8, J3.9, J3.20, J3.29, J3.30, J3.31, J3.35, J3.36, J3.37, J3.38, J3.39, J3.MP (MountPin)
unnamed: J1.8, RN1.4 (R4.1)
unnamed: J1.9, RN1.3 (R3.1)
unnamed: J1.10, RN1.2 (R2.1)
unnamed: J1.11, RN1.1 (R1.1)
unnamed: J1.12, RN2.4 (R4.1)
unnamed: J1.13, RN2.3 (R3.1)
unnamed: J1.15, RN2.1 (R1.1)
unnamed: J1.29, RN3.4 (R4.1)
unnamed: J1.30, RN3.3 (R3.1)
unnamed: J1.32, RN3.2 (R2.1)
unnamed: J1.33, RN3.1 (R1.1)
unnamed: J1.35, RN4.4 (R4.1)
unnamed: J1.36, RN4.3 (R3.1)
unnamed: J1.38, RN4.2 (R2.1)
unnamed: J1.39, RN4.1 (R1.1)

Notes on the sheet:
ED133UT2/ES133UT2

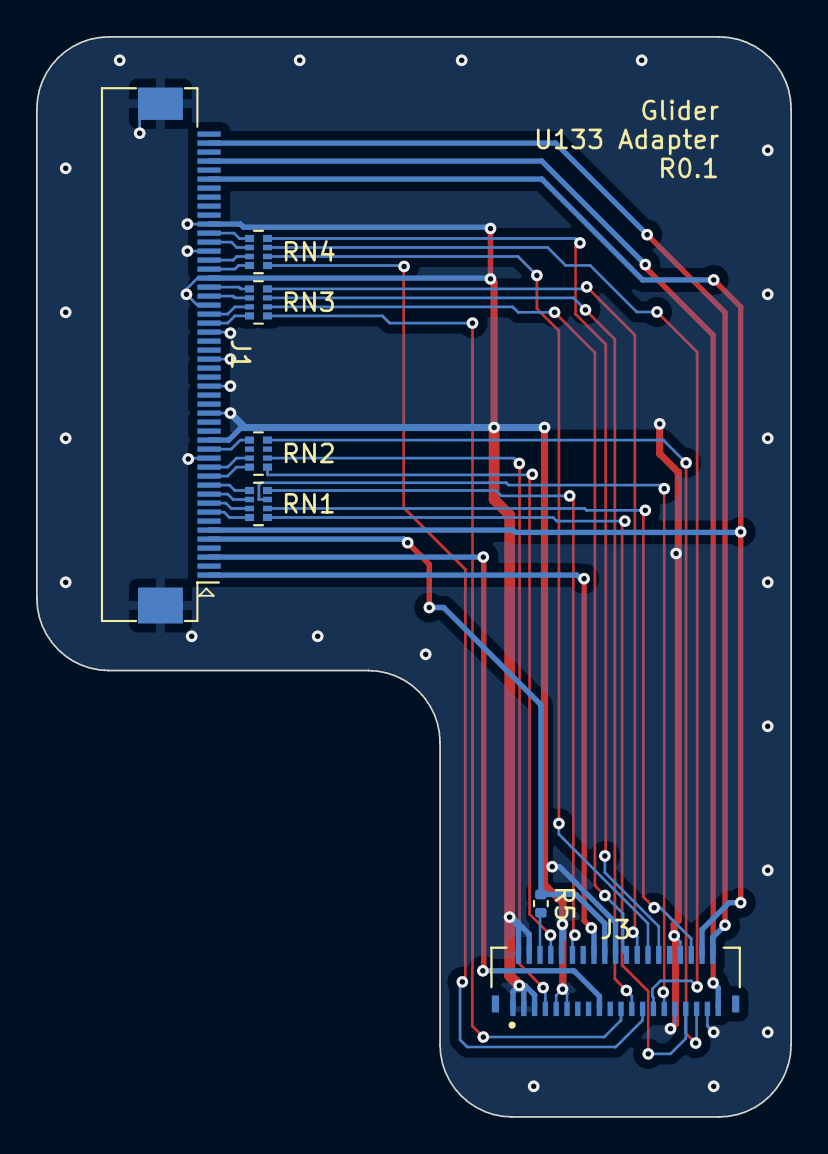
[picture p42: board pcb/u133_adapter/adapter.kicad_pcb from below]

Board: 2 copper layers, 41.9 x 60.0 mm, 7 parts (7 on the bottom side), 38 nets.
