Modos-Labs/Glider/pcb/50p-adapter-c/adapter.kicad_pcb

## KiCad design pcb/50p-adapter-c/adapter.kicad_pcb (2025-05-19, an earlier design)

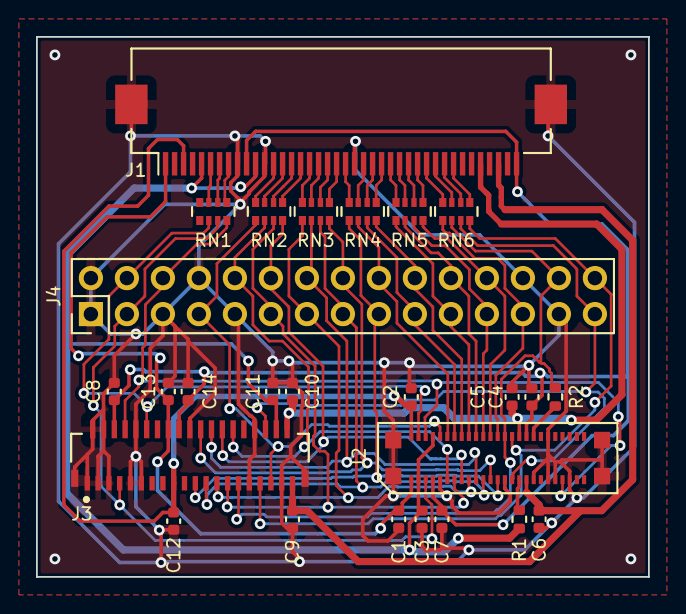
[picture p43: board pcb/50p-adapter-c/adapter.kicad_pcb from above]

Board: 2 copper layers, 34.0 x 30.0 mm, 26 parts (0 on the bottom side), 55 nets.

Parts:
C1, C2, C3, C4, C5, C6, C7, C8, C9, C10, C11, C12, C13, C14: 220nF; C_0402_1005Metric
J1: FH12-40S-0.5SH; Hirose_FH12-40S-0.5SH_1x40-1MP_P0.50mm_Horizontal_Reversed
J2: AXE550127
J3: 10064555-392120HLF; FCI_10064555-392120HLF
J4: Conn_02x15_Odd_Even; PinHeader_2x15_P2.00mm_Vertical
R1: 10K; R_0402_1005Metric
R2: 0R; R_0402_1005Metric
RN1, RN2, RN3, RN4, RN5, RN6: 33; R_Array_Convex_4x0402

Connections:
+3V3: C3.1, C11.1, J1.5, J1.11, J2.3, J2.8, J3.4, R1.1
/ED0: J2.11, J3.12, J4.10, RN2.6 (R3.2)
/ED1: J2.13, J3.13, J4.11, RN2.7 (R2.2)
/ED2: J2.15, J3.14, J4.12, RN2.8 (R1.2)
/ED3: J2.17, J3.15, J4.13, RN3.5 (R4.2)
/ED4: J2.19, J3.16, J4.14, RN3.6 (R3.2)
/ED5: J2.21, J3.17, J4.15, RN3.7 (R2.2)
/ED6: J2.23, J3.18, J4.16, RN3.8 (R1.2)
/ED7: J2.25, J3.19, J4.17, RN4.5 (R4.2)
/ED8: J2.12, J4.18, RN4.6 (R3.2)
/ED9: J2.14, J4.19, RN4.7 (R2.2)
/ED10: J2.16, J4.20, RN4.8 (R1.2)
/ED11: J2.18, J4.21, RN5.5 (R4.2)
/ED12: J2.20, J4.22, RN5.6 (R3.2)
/ED13: J2.22, J4.23, RN5.7 (R2.2)
/ED14: J2.24, J4.24, RN5.8 (R1.2)
/ED15: J2.26, J4.25, RN6.5 (R4.2)
/ESDCLK: J2.10, J3.5, J4.7, RN2.5 (R4.2)
/ESDLE: J2.29, J3.6, J4.29, RN6.7 (R2.2)
/ESDOE: J2.30, J3.7, J4.30, RN6.8 (R1.2)
/GDCLK: J2.5, J3.33, J4.3, RN1.7 (R2.2)
/GDOE: J2.4, J3.28, J4.4, RN1.6 (R3.2)
/GDSP: J2.6, J2.43, J3.32, J4.6, RN1.8 (R1.2)
/SDCE0: J2.28, J3.11, J4.28, R2.1, RN6.6 (R3.2)
GND: C1.2, C2.2, C3.2, C4.2, C5.2, C6.2, C7.2, C8.2, C9.2, C10.2, C11.2, C12.2, C13.2, C14.2, J1.9, J1.12, J1.22, J1.MP (MountPin), J2.9, J2.27, J2.35, J2.39, J2.40, J2.41, J2.45, J2.MP (MountPin), J3.3, J3.8, J3.9, J3.20, J3.29, J3.30, J3.31, J3.35, J3.36, J3.37, J3.38, J3.39, J3.MP (MountPin), J4.1, J4.2, J4.5, J4.8, J4.9, J4.26, J4.27
unnamed: J1.6, RN1.3 (R3.1)
unnamed: J1.7, RN1.2 (R2.1)
unnamed: J1.8, RN1.1 (R1.1)
unnamed: J1.13, RN2.4 (R4.1)
unnamed: J1.14, RN2.3 (R3.1)
unnamed: J1.15, RN2.2 (R2.1)
unnamed: J1.16, RN2.1 (R1.1)
unnamed: J1.17, RN3.4 (R4.1)
unnamed: J1.18, RN3.3 (R3.1)
unnamed: J1.19, RN3.2 (R2.1)
unnamed: J1.20, RN3.1 (R1.1)
unnamed: J1.21, RN4.4 (R4.1)
unnamed: J1.23, RN4.3 (R3.1)
unnamed: J1.24, RN4.2 (R2.1)
unnamed: J1.25, RN4.1 (R1.1)
unnamed: J1.26, RN5.4 (R4.1)
unnamed: J1.27, RN5.3 (R3.1)
unnamed: J1.28, RN5.2 (R2.1)
unnamed: J1.29, RN5.1 (R1.1)
unnamed: J1.30, RN6.4 (R4.1)
unnamed: J1.31, RN6.3 (R3.1)
unnamed: J1.32, RN6.2 (R2.1)
unnamed: J1.33, RN6.1 (R1.1)
unnamed: J2.31, R1.2
unnamed: J2.36, R2.2
VCOM: C4.1, C7.1, C8.1, C14.1, J1.10, J1.40, J2.7, J2.34, J3.22, J3.34
VGH: C2.1, C12.1, J1.3, J2.2, J3.23
VGL: C1.1, C13.1, J1.1, J2.1, J3.24
VNEG: C6.1, C9.1, J1.38, J2.33, J3.1
VPOS: C5.1, C10.1, J1.36, J2.32, J3.2
