Modos-Labs/Glider/pcb/mainboard/pcb.kicad_pcb

## KiCad design pcb/mainboard/pcb.kicad_pcb (2024-05-03)

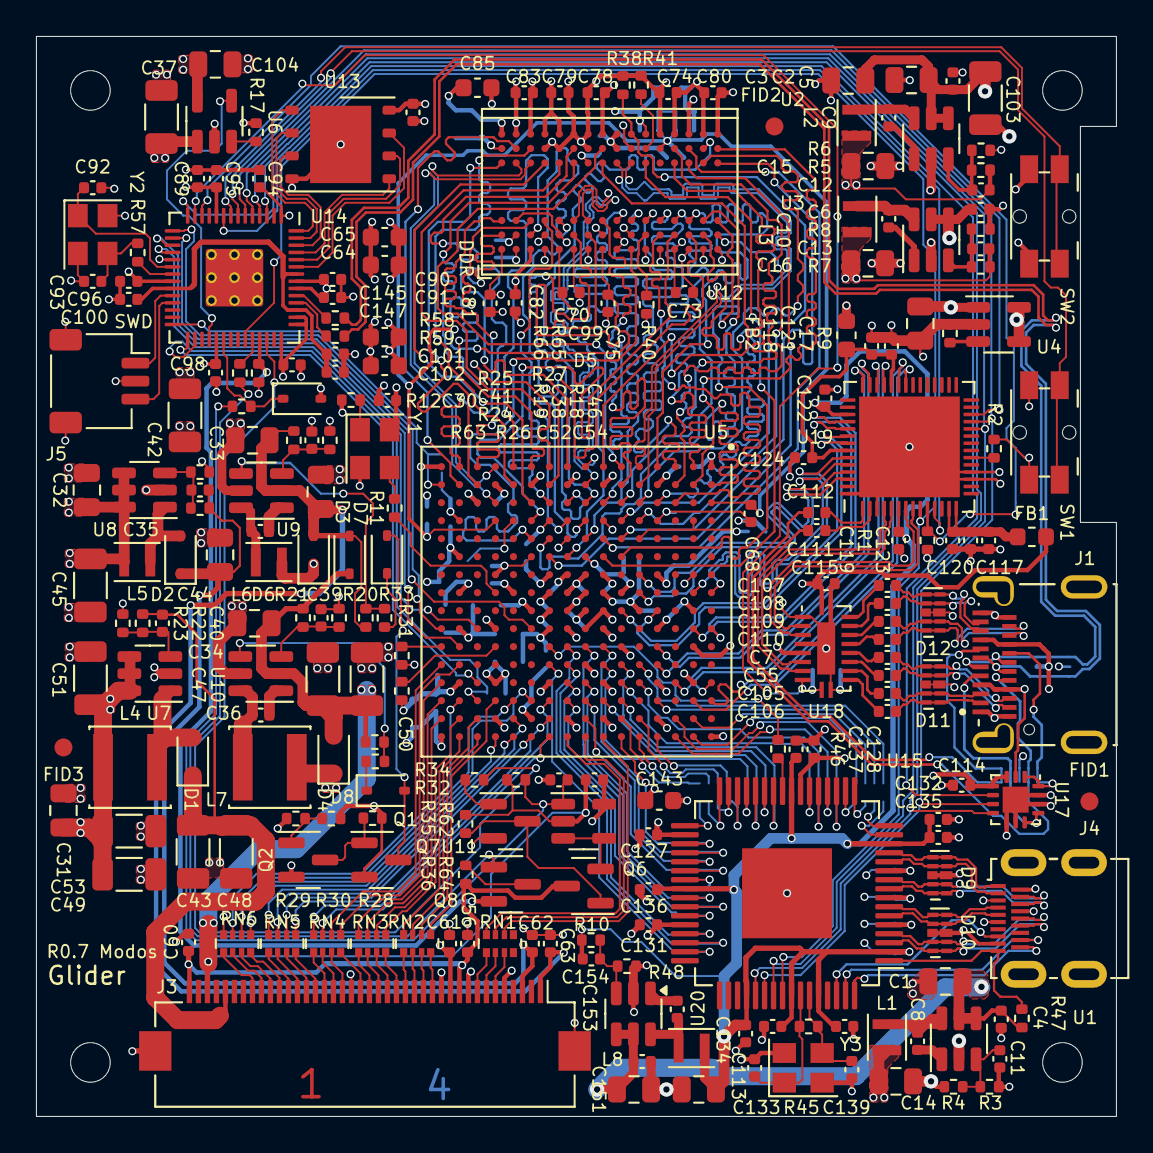
[picture p44: board pcb.kicad_pcb from above]

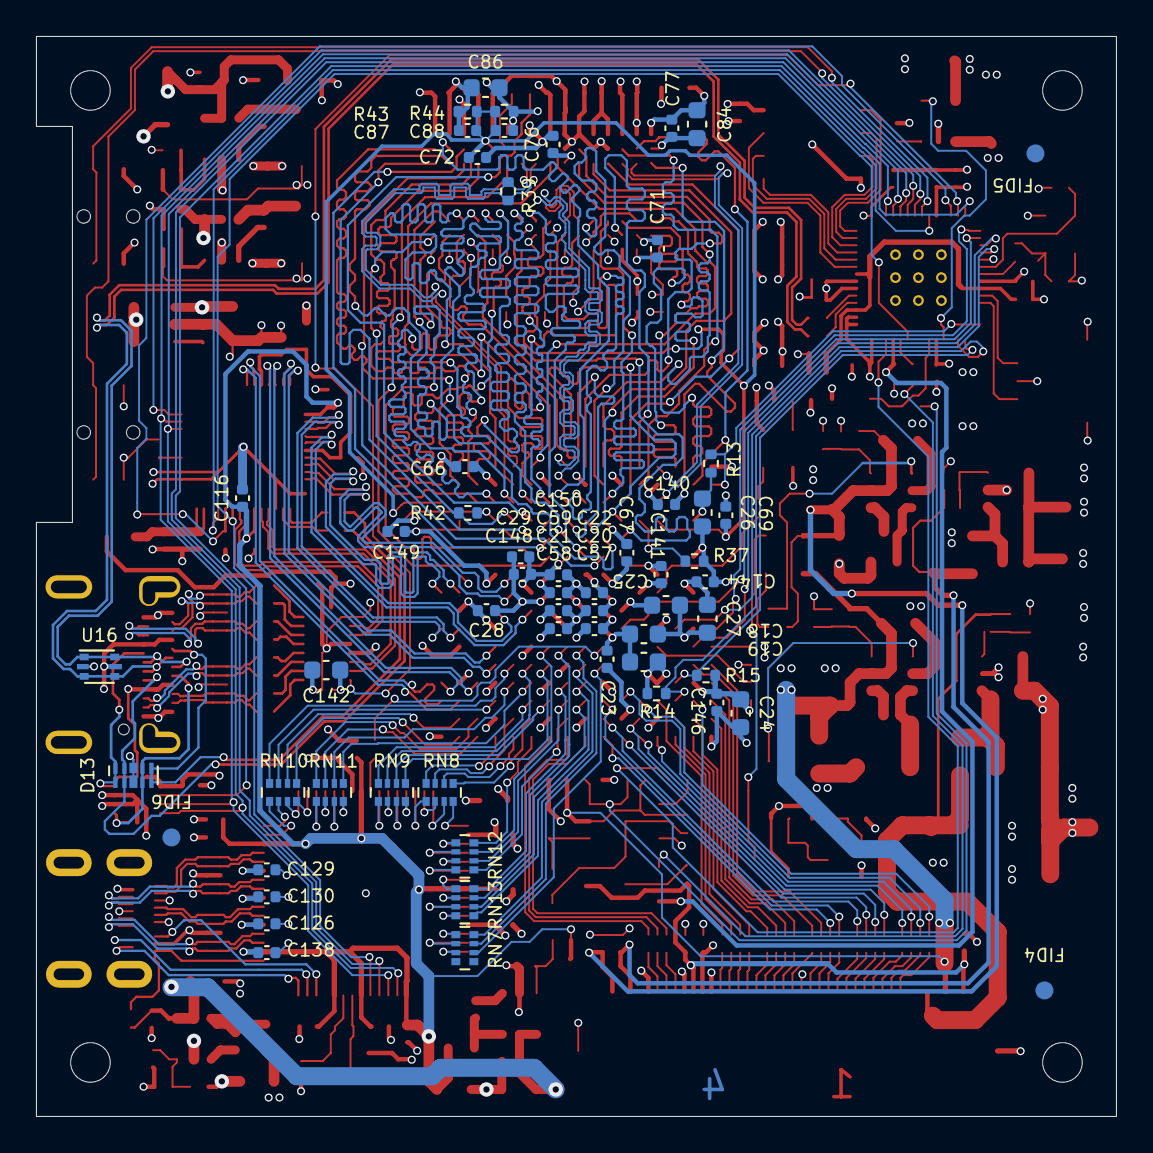
[picture p45: board pcb.kicad_pcb from below]

Board: 4 copper layers, 60.0 x 60.0 mm, 290 parts (59 on the bottom side), 305 nets.

Parts:
C1, C2, C3, C14, C15, C16, C17, C31, C32, C104, C151, C155: 10uF/10V; C_0805_2012Metric
C4, C5, C6, C7, C8, C9, C10, C35, C36, C54, C55, C87, C88, C90, C91, C94, C95, C96, C97, C98, C99, C100, C101, C105, C106, C107, C108, C109, C110, C111, C112, C114, C115, C119, C120, C121, C122, C123, C124, C127, C128, C129, C130, C131, C133, C134, C135, C136, C137, C138, C139, C152, C153: 100nF; C_0402_1005Metric
C11, C12, C13, C154: 47pF; C_0402_1005Metric
C18, C19, C24, C25, C26, C27, C64, C65, C142, C143, C145, C147: 47uF/6.3V; C_0603_1608Metric
C20, C22, C23, C28, C57, C59, C66, C144, C148: 4.7uF; C_0402_1005Metric
C21, C29, C58, C67, C140, C141, C146, C149, C150: 470nF; C_0402_1005Metric
C30, C52, C60, C61, C62, C63, C68, C69, C70, C71, C72, C73, C74, C75, C76, C77, C78, C79, C80, C81, C82, C83: 220nF; C_0402_1005Metric
C33, C34, C44, C46: 4.7uF/50V; C_0805_2012Metric
C37, C42, C45, C49, C51, C53, C103: 47uF/10V; C_1206_3216Metric
C38, C39, C40, C41: 22pF; C_0402_1005Metric
C43, C47, C48, C50: 10uF/50V; C_1206_3216Metric
C56, C89, C102, C116, C117, C118, C126, C132: 1uF; C_0402_1005Metric
C84, C85, C86: 22uF; C_0603_1608Metric
C92, C93, C113, C125: 18pF; C_0402_1005Metric
D1, D2, D3, D4, D6: 1N5819WS; D_SOD-323
D5, D7, D8: 4148WS; D_SOD-323
D9, D10, D11, D12, D13: RCLAMP0524P; Diodes_UDFN-10_1.0x2.5mm_P0.5mm
FB1, FB2: 120; L_0603_1608Metric
FID1, FID2, FID3, FID4, FID5, FID6: Fiducial; Fiducial_1mm_Mask2mm
H1, H2, H3, H4: MountingHole; MountingHole_2.2mm_M2_DIN965
J1: USB_C_Receptacle; AMPHENOL_10137065-00021LF
J3: FH12-40S-0.5SH; Hirose_FH12-40S-0.5SH_1x40-1MP_P0.50mm_Horizontal_Reversed
J4: DVI; HDMI_Micro-D_Molex_46765-1x01_MOD
J5: SM03B-SRSS-TB; JST_SH_SM03B-SRSS-TB_1x03-1MP_P1.00mm_Horizontal
L1, L2, L3, L5, L6, L8: FTC201610S4R7MBCA; L_Murata_DFE201610P
L4, L7: WPN4020H4R7MT; L_Changjiang_FNR4020S
Q1, Q7, Q8: AO3401A; SOT-23
Q2: S8050; SOT-23
Q6: AO3400A; SOT-23
R1, R2, R12, R13, R14, R38, R40, R42: 4.7K; R_0402_1005Metric
R3, R20, R26: 91K/1%; R_0402_1005Metric
R4, R5, R7, R8, R10, R64: 20K/1%; R_0402_1005Metric
R6: 16K/1%; R_0402_1005Metric
R9, R17, R19, R23, R25, R48, R65: 10K/1%; R_0402_1005Metric
R11, R58, R59: 27R; R_0402_1005Metric
R15, R43, R44: 1K/1%; R_0402_1005Metric
R18, R22: 240K/1%; R_0402_1005Metric
R21, R29: 5.1K/1%; R_0402_1005Metric
R24: 360K/1%; R_0402_1005Metric
R27, R30: 27K/1%; R_0402_1005Metric
R28, R31, R32, R33, R34, R62: 120K/1%; R_0402_1005Metric
R35, R36: 0R; R_0402_1005Metric
R37, R39: 100R/1%; R_0402_1005Metric
R41: 240R/1%; R_0402_1005Metric
R45: 1M; R_0402_1005Metric
R46: 33; R_0402_1005Metric
R47: 10K; R_0402_1005Metric
R57: 1K; R_0402_1005Metric
R63, R66: 51R; R_0402_1005Metric
RN1, RN2, RN3, RN4, RN5, RN6, RN7, RN8, RN9, RN10, RN11, RN12, RN13: 33R / 4D02WGF330JTCE; R_Array_Convex_4x0402
SW1, SW2: SW; Panasonic_EVQPUL_EVQPUC
U1, U2, U3, U20: SY8120; TSOT-23-6
U4, U6: MT9700; SOT-23-5
U5: XC6SLX16-FTG256; Xilinx_FTG256
U7, U8: MT3608(SOT23-6); SOT-23-6
U9, U10: LGS5148; TSOT-23-6
U11: LM321; SOT-23-5
U12: MT41K64M16TW; BGA-96_9.0x14.0mm_P0.8mm
U13: W25Q32JV; WSON-8-1EP_6x5mm_P1.27mm_EP3.4x4.3mm
U14: RP2040; RP2040-QFN-56
U15: ADV7611; LQFP-64-1EP_10x10mm_P0.5mm_EP5x5mm
U16: USBLC6-2P6; SOT-666
U17: FUSB302BMPX; WQFN-14-1EP_2.5x2.5mm_P0.5mm_EP1.45x1.45mm
U18: CBTL02043A; WQFN-20-1EP_2.5x4.5mm_P0.5mm_EP1x2.9mm
U19: PTN3460; QFN-56-1EP_7x7mm_P0.4mm_EP5.6x5.6mm
Y1: 33MHz; Oscillator_SMD_Abracon_ASE-4Pin_3.2x2.5mm
Y2: 12MHz; Oscillator_SMD_Abracon_ASE-4Pin_3.2x2.5mm
Y3: 28.63636MHz; Oscillator_SMD_Abracon_ASE-4Pin_3.2x2.5mm

Connections:
+1V2: C13.2, C16.2, C18.1, C19.1, C20.1, C21.1, C22.1, C23.1, C59.1, L3.2, R7.2, U5.G7 (VCCINT), U5.G9 (VCCINT), U5.H8 (VCCINT), U5.H10 (VCCINT), U5.J7 (VCCINT), U5.J9 (VCCINT), U5.K8 (VCCINT), U5.K10 (VCCINT)
+1V8: C116.1, C119.1, C122.1, C132.1, C133.1, C134.1, C135.1, C136.1, C137.1, C138.1, C139.1, C154.2, C155.2, L8.2, R10.2, U15.2 (CVDD), U15.14 (CVDD), U15.24 (DVDD), U15.40 (DVDD), U15.52 (DVDD), U15.57 (PVDD), U15.60 (DVDD), U19.6 (VDD18), U19.45 (VDD18)
+1V35: C12.2, C15.2, C64.1, C65.1, C66.1, C67.1, C70.1, C71.1, C73.1, C74.1, C76.1, C77.1, C78.1, C79.1, C80.1, C81.1, C82.1, C83.1, C84.1, C85.1, C86.1, C87.1, C140.1, L2.2, R5.2, R43.1, U5.D2 (VCCO_3), U5.G4 (VCCO_3), U5.J2 (VCCO_3), U5.K4 (VCCO_3), U5.N2 (VCCO_3), U12.A1 (VDDQ), U12.A8 (VDDQ), U12.B2 (VDD), U12.C1 (VDDQ), U12.C9 (VDDQ), U12.D2 (VDDQ), U12.D9 (VDD), U12.E9 (VDDQ), U12.F1 (VDDQ), U12.G7 (VDD), U12.H2 (VDDQ), U12.H9 (VDDQ), U12.K2 (VDD), U12.K8 (VDD), U12.N1 (VDD), U12.N9 (VDD), U12.R1 (VDD), U12.R9 (VDD)
+3V3: C11.2, C14.2, C24.1, C25.1, C26.1, C27.1, C28.1, C29.1, C30.2, C57.1, C58.1, C61.1, C89.1, C90.1, C91.1, C94.1, C95.1, C96.1, C97.1, C98.1, C99.1, C114.1, C115.1, C126.1, C127.1, C128.1, C129.1, C130.1, C131.1, C141.1, C142.1, C143.1, C144.1, C145.1, C146.1, C147.1, C148.1, C149.1, C150.1, FB1.1, FB2.1, J3.5, J3.11, L1.2, Q7.2 (S), R3.2, R12.1, R13.1, R15.1, R35.1, R36.1, R65.1, U5.B4 (VCCO_0), U5.B9 (VCCO_0), U5.B13 (VCCO_0), U5.D7 (VCCO_0), U5.D10 (VCCO_0), U5.D15 (VCCO_1), U5.E5 (VCCAUX), U5.F8 (VCCAUX), U5.F11 (VCCAUX), U5.G10 (VCCAUX), U5.G13 (VCCO_1), U5.H6 (VCCAUX), U5.J10 (VCCAUX), U5.J15 (VCCO_1), U5.K13 (VCCO_1), U5.L6 (VCCAUX), U5.L9 (VCCAUX), U5.N7 (VCCO_2), U5.N10 (VCCO_2), U5.N15 (VCCO_1), U5.R4 (VCCO_2), U5.R8 (VCCO_2), U5.R13 (VCCO_1), U13.8 (VCC), U14.1 (IOVDD), U14.10 (IOVDD), U14.22 (IOVDD), U14.33 (IOVDD), U14.42 (IOVDD), U14.43 (ADC_AVDD), U14.44 (VREG_IN), U14.48 (USB_VDD), U14.49 (IOVDD), U15.5 (TVDD), U15.8 (TVDD), U15.11 (TVDD), U15.23 (DVDDIO), U15.34 (DVDDIO), U15.44 (DVDDIO), U17.3 (VDD), U17.4 (VDD), U18.1 (VDD), U18.6 (VDD), U18.10 (VDD), Y1.4 (Vdd)
+5V: C1.2, C2.2, C3.2, C4.2, C5.2, C6.2, C17.2, C103.2, C151.2, C152.2, R47.1, U1.4 (~SHDN), U1.5 (IN), U2.4 (~SHDN), U2.5 (IN), U3.4 (~SHDN), U3.5 (IN), U4.1 (VOUT), U20.4 (~SHDN), U20.5 (IN)
+5V_EPD: C31.2, C32.2, C33.2, C34.2, C37.2, C42.2, C45.2, C49.2, C51.2, C53.2, L4.1, L5.1, Q1.2 (S), R28.2, R30.1, U6.1 (VOUT), U7.4 (~SHDN), U7.5 (VIN), U7.6 (NC), U8.4 (~SHDN), U8.5 (VIN), U8.6 (NC), U9.5 (IN), U10.5 (IN)
+DRAM_VREF: C68.1, C69.1, C72.1, C75.1, C87.2, C88.1, R43.2, R44.1, U5.A3 (IO_L83N_VREF_3), U5.N4 (IO_L2N_3), U12.H1 (VrefDQ), U12.M8 (VrefCA)
/dp_in/CC1: D13.4 (IO3), D13.7 (NC2), J1.A5 (CC1), U17.10 (CC1), U17.11 (CC1)
/dp_in/CC2: D13.1 (IO1), D13.10 (NC4), J1.B5 (CC2), U17.1 (CC2), U17.14 (CC2)
/dp_in/DP0N: U18.7 (A1_P), U19.5 (DP0_N)
/dp_in/DP0P: U18.8 (A1_N), U19.4 (DP0_P)
/dp_in/DP1N: U18.3 (A0_P), U19.8 (DP1_N)
/dp_in/DP1P: U18.4 (A0_N), U19.7 (DP1_P)
/dp_in/DPAUXN: C112.2, U19.1 (AUX_N)
/dp_in/DPAUXP: C111.2, U19.2 (AUX_P)
/dp_in/RX1N: C105.1, D11.2 (IO2), D11.9 (NC3), J1.A3 (TX1-)
/dp_in/RX1NC: C105.2, U18.13 (C1_P)
/dp_in/RX1P: C106.1, D11.1 (IO1), D11.10 (NC4), J1.A2 (TX1+)
/dp_in/RX1PC: C106.2, U18.12 (C1_N)
/dp_in/RX2N: C109.1, D12.2 (IO2), D12.9 (NC3), J1.B3 (TX2-)
/dp_in/RX2NC: C109.2, U18.17 (B1_P)
/dp_in/RX2P: C110.1, D12.1 (IO1), D12.10 (NC4), J1.B2 (TX2+)
/dp_in/RX2PC: C110.2, U18.16 (B1_N)
/dp_in/SBU1: C111.1, D13.5 (IO4), D13.6 (NC1), J1.A8 (SBU1)
/dp_in/SBU2: C112.1, D13.2 (IO2), D13.9 (NC3), J1.B8 (SBU2)
/dp_in/TX1N: C7.1, D11.5 (IO4), D11.6 (NC1), J1.B10 (RX1-)
/dp_in/TX1NC: C7.2, U18.15 (C0_P)
/dp_in/TX1P: C55.1, D11.4 (IO3), D11.7 (NC2), J1.B11 (RX1+)
/dp_in/TX1PC: C55.2, U18.14 (C0_N)
/dp_in/TX2N: C107.1, D12.5 (IO4), D12.6 (NC1), J1.A10 (RX2-)
/dp_in/TX2NC: C107.2, U18.19 (B0_P)
/dp_in/TX2P: C108.1, D12.4 (IO3), D12.7 (NC2), J1.A11 (RX2+)
/dp_in/TX2PC: C108.2, U18.18 (B0_N)
/eink/ED0: J3.14, RN2.3 (R3.1)
/eink/ED1: J3.15, RN2.2 (R2.1)
/eink/ED2: J3.16, RN2.1 (R1.1)
/eink/ED3: J3.17, RN3.4 (R4.1)
/eink/ED4: J3.18, RN3.3 (R3.1)
/eink/ED5: J3.19, RN3.2 (R2.1)
/eink/ED6: J3.20, RN3.1 (R1.1)
/eink/ED7: J3.21, RN4.4 (R4.1)
/eink/ED8: J3.23, RN4.3 (R3.1)
/eink/ED9: J3.24, RN4.2 (R2.1)
/eink/ED10: J3.25, RN4.1 (R1.1)
/eink/ED11: J3.26, RN5.4 (R4.1)
/eink/ED12: J3.27, RN5.3 (R3.1)
/eink/ED13: J3.28, RN5.2 (R2.1)
/eink/ED14: J3.29, RN5.1 (R1.1)
/eink/ED15: J3.30, RN6.4 (R4.1)
/eink/EN_VGL: R31.1, R33.2, U9.4 (~SHDN)
/eink/EN_VNEG: R32.1, R34.2, U10.4 (~SHDN)
/eink/ESDCLK: J3.13, RN2.4 (R4.1)
/eink/ESDLE: J3.32, RN6.2 (R2.1)
/eink/ESDOE: J3.33, RN6.1 (R1.1)
/eink/GDCLK: J3.7, RN1.2 (R2.1)
/eink/GDOE: J3.6, RN1.3 (R3.1)
/eink/GDSP: J3.8, RN1.1 (R1.1)
/eink/SDCE0: J3.31, RN6.3 (R3.1)
/fpga_ddr/DRAM_ADDR0: U5.K5 (IO_L47P_M3A0_3), U12.N3 (A0)
/fpga_ddr/DRAM_ADDR1: U5.K6 (IO_L47N_M3A1_3), U12.P7 (A1)
/fpga_ddr/DRAM_ADDR2: U5.D1 (IO_L49N_M3A2_3), U12.P3 (A2)
/fpga_ddr/DRAM_ADDR3: U5.L4 (IO_L45P_M3A3_3), U12.N2 (A3)
/fpga_ddr/DRAM_ADDR4: U5.G5 (IO_L51N_M3A4_3), U12.P8 (A4)
/fpga_ddr/DRAM_ADDR5: U5.H4 (IO_L44P_GCLK21_M3A5_3), U12.P2 (A5)
/fpga_ddr/DRAM_ADDR6: U5.H3 (IO_L44N_GCLK20_M3A6_3), U12.R8 (A6)
/fpga_ddr/DRAM_ADDR7: U5.D3 (IO_L49P_M3A7_3), U12.R2 (A7)
/fpga_ddr/DRAM_ADDR8: U5.B2 (IO_L52P_M3A8_3), U12.T8 (A8)
/fpga_ddr/DRAM_ADDR9: U5.A2 (IO_L52N_M3A9_3), U12.R3 (A9)
/fpga_ddr/DRAM_ADDR10: U5.G6 (IO_L51P_M3A10_3), U12.L7 (A10)
/fpga_ddr/DRAM_ADDR11: U5.E3 (IO_L54N_M3A11_3), U12.R7 (A11)
/fpga_ddr/DRAM_ADDR12: U5.F3 (IO_L53N_M3A12_3), U12.N7 (A12/~BC)
/fpga_ddr/DRAM_ADDR13: U5.F6 (IO_L55P_M3A13_3), U12.T3 (A13)
/fpga_ddr/DRAM_ADDR14: U5.F5 (IO_L55N_M3A14_3), U12.T7 (A14/NC)
/fpga_ddr/DRAM_BA0: U5.C3 (IO_L48P_M3BA0_3), U12.M2 (BA0)
/fpga_ddr/DRAM_BA1: U5.C2 (IO_L48N_M3BA1_3), U12.N8 (BA1)
/fpga_ddr/DRAM_BA2: U5.B1 (IO_L50N_M3BA2_3), U12.M3 (BA2)
/fpga_ddr/DRAM_CASB: U5.H5 (IO_L43N_GCLK22_IRDY2_M3CASN_3), U12.K3 (~CAS)
/fpga_ddr/DRAM_CKE: R38.1, U5.F4 (IO_L53P_M3CKE_3), U12.K9 (CKE)
/fpga_ddr/DRAM_CKN: R39.1, U5.E1 (IO_L46N_M3CLKN_3), U12.K7 (~CK)
/fpga_ddr/DRAM_CKP: R39.2, U5.E2 (IO_L46P_M3CLK_3), U12.J7 (CK)
/fpga_ddr/DRAM_CSB: R40.1, U12.L2 (~CS)
/fpga_ddr/DRAM_DATA0: U5.K2 (IO_L37P_M3DQ0_3), U12.E3 (DQ0)
/fpga_ddr/DRAM_DATA1: U5.K1 (IO_L37N_M3DQ1_3), U12.F7 (DQ1)
/fpga_ddr/DRAM_DATA2: U5.J3 (IO_L38P_M3DQ2_3), U12.F2 (DQ2)
/fpga_ddr/DRAM_DATA3: U5.J1 (IO_L38N_M3DQ3_3), U12.F8 (DQ3)
/fpga_ddr/DRAM_DATA4: U5.F2 (IO_L41P_GCLK27_M3DQ4_3), U12.H3 (DQ4)
/fpga_ddr/DRAM_DATA5: U5.F1 (IO_L41N_GCLK26_M3DQ5_3), U12.H8 (DQ5)
/fpga_ddr/DRAM_DATA6: U5.G3 (IO_L40P_M3DQ6_3), U12.G2 (DQ6)
/fpga_ddr/DRAM_DATA7: U5.G1 (IO_L40N_M3DQ7_3), U12.H7 (DQ7)
/fpga_ddr/DRAM_DATA8: U5.L3 (IO_L36P_M3DQ8_3), U12.D7 (DQ8)
/fpga_ddr/DRAM_DATA9: U5.L1 (IO_L36N_M3DQ9_3), U12.C3 (DQ9)
/fpga_ddr/DRAM_DATA10: U5.M2 (IO_L35P_M3DQ10_3), U12.C8 (DQ10)
/fpga_ddr/DRAM_DATA11: U5.M1 (IO_L35N_M3DQ11_3), U12.C2 (DQ11)
/fpga_ddr/DRAM_DATA12: U5.P2 (IO_L33P_M3DQ12_3), U12.A7 (DQ12)
/fpga_ddr/DRAM_DATA13: U5.P1 (IO_L33N_M3DQ13_3), U12.A2 (DQ13)
/fpga_ddr/DRAM_DATA14: U5.R2 (IO_L32P_M3DQ14_3), U12.B8 (DQ14)
/fpga_ddr/DRAM_DATA15: U5.R1 (IO_L32N_M3DQ15_3), U12.A3 (DQ15)
/fpga_ddr/DRAM_LDM: U5.J4 (IO_L42N_GCLK24_M3LDM_3), U12.E7 (LDM)
/fpga_ddr/DRAM_LDQSN: U5.H1 (IO_L39N_M3LDQSN_3), U12.G3 (~LDQS)
/fpga_ddr/DRAM_LDQSP: U5.H2 (IO_L39P_M3LDQS_3), U12.F3 (LDQS)
/fpga_ddr/DRAM_ODT: U5.L5 (IO_L45N_M3ODT_3), U12.K1 (ODT)
/fpga_ddr/DRAM_RASB: U5.J6 (IO_L43P_GCLK23_M3RASN_3), U12.J3 (~RAS)
/fpga_ddr/DRAM_RST: R42.1, U5.E4 (IO_L54P_M3RESET_3), U12.T2 (~RESET)
/fpga_ddr/DRAM_UDM: U5.K3 (IO_L42P_GCLK25_TRDY2_M3UDM_3), U12.D3 (UDM)
/fpga_ddr/DRAM_UDQSN: U5.N1 (IO_L34N_M3UDQSN_3), U12.B7 (~UDQS)
/fpga_ddr/DRAM_UDQSP: U5.N3 (IO_L34P_M3UDQS_3), U12.C7 (UDQS)
/fpga_ddr/DRAM_WEB: U5.C1 (IO_L50P_M3WE_3), U12.L3 (~WE)
/mcu/MCU_1V1: C100.1, C101.1, C102.1, U14.23 (DVDD), U14.45 (VREG_VOUT), U14.50 (DVDD)
/mcu/QSPI_SCLK: U13.6 (CLK), U14.52 (QSPI_SCLK)
/mcu/QSPI_SD0: U13.5 (DI(IO0)), U14.53 (QSPI_SD0)
/mcu/QSPI_SD1: U13.2 (DO(IO1)), U14.55 (QSPI_SD1)
/mcu/QSPI_SD2: U13.3 (IO2), U14.54 (QSPI_SD2)
/mcu/QSPI_SD3: U13.7 (IO3), U14.51 (QSPI_SD3)
/mcu/QSPI_SS: U13.1 (~CS), U14.56 (QSPI_SS)
/mcu/SWCLK: J5.1, U14.24 (SWCLK)
/mcu/SWD: J5.3, U14.25 (SWD)
/mcu/XIN: C92.1, U14.20 (XIN), Y2.1
/mcu/XOUT: R57.1, U14.21 (XOUT)
/tmds_in/ADV_CK: R46.2, U15.25 (LLC)
/tmds_in/ADV_DE: RN7.1 (R1.1), U15.45 (DE)
/tmds_in/ADV_HS: RN7.2 (R2.1), U15.46 (HS)
/tmds_in/ADV_P0: RN13.4 (R4.1), U15.43 (P0)
/tmds_in/ADV_P1: RN13.3 (R3.1), U15.42 (P1)
/tmds_in/ADV_P2: RN13.2 (R2.1), U15.41 (P2)
/tmds_in/ADV_P3: RN13.1 (R1.1), U15.39 (P3)
/tmds_in/ADV_P4: RN12.4 (R4.1), U15.38 (P4)
/tmds_in/ADV_P5: RN12.3 (R3.1), U15.37 (P5)
/tmds_in/ADV_P6: RN12.2 (R2.1), U15.36 (P6)
/tmds_in/ADV_P7: RN12.1 (R1.1), U15.35 (P7)
/tmds_in/ADV_P8: RN8.4 (R4.1), U15.33 (P8)
/tmds_in/ADV_P9: RN8.3 (R3.1), U15.32 (P9)
/tmds_in/ADV_P10: RN8.2 (R2.1), U15.31 (P10)
/tmds_in/ADV_P11: RN8.1 (R1.1), U15.30 (P11)
/tmds_in/ADV_P12: RN9.4 (R4.1), U15.29 (P12)
/tmds_in/ADV_P13: RN9.3 (R3.1), U15.28 (P13)
/tmds_in/ADV_P14: RN9.2 (R2.1), U15.27 (P14)
/tmds_in/ADV_P15: RN9.1 (R1.1), U15.26 (P15)
/tmds_in/ADV_P16: RN11.4 (R4.1), U15.22 (P16)
/tmds_in/ADV_P17: RN11.3 (R3.1), U15.21 (P17)
/tmds_in/ADV_P18: RN11.2 (R2.1), U15.20 (P18)
/tmds_in/ADV_P19: RN11.1 (R1.1), U15.19
/tmds_in/ADV_P20: RN10.4 (R4.1), U15.18 (P20)
/tmds_in/ADV_P21: RN10.3 (R3.1), U15.17 (P21)
/tmds_in/ADV_P22: RN10.2 (R2.1), U15.16 (P22)
/tmds_in/ADV_P23: RN10.1 (R1.1), U15.15 (P23)
/tmds_in/ADV_VS: RN7.3 (R3.1), U15.47 (VS/FIELD/ALSB)
/tmds_in/HDMI_5V: J4.18 (+5V), U15.64 (RXA_5V)
/tmds_in/HDMI_HPD: J4.19 (HPD), R47.2, U15.1 (HPA_A/INT2)
/tmds_in/HDMI_SCL: J4.15 (SCL), U15.62 (DDCA_SCL)
/tmds_in/HDMI_SDA: J4.16 (SDA), U15.63 (DDCA_SDA)
/tmds_in/TMDS_CKN: D10.1 (IO1), D10.10 (NC4), J4.12 (CK-), U15.3 (RXA_C-)
/tmds_in/TMDS_CKP: D10.2 (IO2), D10.9 (NC3), J4.10 (CK+), U15.4 (RXA_C+)
/tmds_in/TMDS_D0N: D10.4 (IO3), D10.7 (NC2), J4.9 (D0-), U15.6 (RXA_0-)
/tmds_in/TMDS_D0P: D10.5 (IO4), D10.6 (NC1), J4.7 (D0+), U15.7 (RXA_0+)
/tmds_in/TMDS_D1N: D9.1 (IO1), D9.10 (NC4), J4.6 (D1-), U15.9 (RXA_1-)
/tmds_in/TMDS_D1P: D9.2 (IO2), D9.9 (NC3), J4.4 (D1+), U15.10 (RXA_1+)
/tmds_in/TMDS_D2N: D9.4 (IO3), D9.7 (NC2), J4.3 (D2-), U15.12 (RXA_2-)
/tmds_in/TMDS_D2P: D9.5 (IO4), D9.6 (NC1), J4.1 (D2+), U15.13 (RXA_2+)
ADV_INT: U14.3 (GPIO1), U15.55 (INT1)
DEC_RST: U14.37 (GPIO25), U15.56 (~RESET), U19.9 (RST_N)
DPI_B0: RN13.5 (R4.2), U5.J13 (IO_L41P_GCLK9_IRDY1_M1RASN_1)
DPI_B1: RN13.6 (R3.2), U5.J14 (IO_L43P_GCLK5_M1DQ4_1)
DPI_B2: RN13.7 (R2.2), U5.H11 (IO_L38N_A4_M1CLKN_1)
DPI_B3: RN13.8 (R1.2), U5.H13 (IO_L39P_M1A3_1)
DPI_B4: RN12.5 (R4.2), U5.H15 (IO_L37P_A7_M1A0_1)
DPI_B5: RN12.6 (R3.2), U5.H14 (IO_L39N_M1ODT_1)
DPI_B6: RN12.7 (R2.2), U5.G11 (IO_L30N_A20_M1A11_1)
DPI_B7: RN12.8 (R1.2), U5.F16 (IO_L35N_A10_M1A2_1)
DPI_DE: RN7.8 (R1.2), U5.J12 (IO_L40N_GCLK10_M1A6_1)
DPI_G0: RN8.5 (R4.2), U5.F15 (IO_L35P_A11_M1A7_1)
DPI_G1: RN8.6 (R3.2), U5.E16 (IO_L34N_A12_M1BA2_1)
DPI_G2: RN8.7 (R2.2), U5.E15 (IO_L34P_A13_M1WE_1)
DPI_G3: RN8.8 (R1.2), U5.D16 (IO_L31N_A18_M1A12_1)
DPI_G4: RN9.5 (R4.2), U5.G12 (IO_L38P_A5_M1CLK_1)
DPI_G5: RN9.6 (R3.2), U5.G14 (IO_L36P_A9_M1BA0_1)
DPI_G6: RN9.7 (R2.2), U5.F12 (IO_L30P_A21_M1RESET_1)
DPI_G7: RN9.8 (R1.2), U5.F14 (IO_L32N_A16_M1A9_1)
DPI_HS: RN7.7 (R2.2), U5.J11 (IO_L40P_GCLK11_M1A5_1)
DPI_PCLK: R46.1, U5.K11 (IO_L42N_GCLK6_TRDY1_M1LDM_1)
DPI_R0: RN11.5 (R4.2), U5.F13 (IO_L32P_A17_M1A8_1)
DPI_R1: RN11.6 (R3.2), U5.E13 (IO_L1P_A25_1)
DPI_R2: RN11.7 (R2.2), U5.C16 (IO_L33N_A14_M1A4_1)
DPI_R3: RN11.8 (R1.2), U5.C15 (IO_L33P_A15_M1A10_1)
DPI_R4: RN10.5 (R4.2), U5.B16 (IO_L29N_A22_M1A14_1)
DPI_R5: RN10.6 (R3.2), U5.B15 (IO_L29P_A23_M1A13_1)
DPI_R6: RN10.7 (R2.2), U5.D14 (IO_L31P_A19_M1CKE_1)
DPI_R7: RN10.8 (R1.2), U5.E12 (IO_L1N_A24_VREF_1)
DPI_VS: RN7.6 (R3.2), U5.K12 (IO_L42P_GCLK7_M1UDM_1)
DP_HPD: U14.9 (GPIO7), U19.11 (HPDRX)
DP_PDN: R1.2, U14.12 (GPIO9), U19.10 (PD_N)
DP_VALID: U14.6 (GPIO4), U19.26 (BKLTEN)
EPDC_D0: RN2.6 (R3.2), U5.P16 (IO_L48N_M1DQ9_1)
EPDC_D1: RN2.7 (R2.2), U5.P15 (IO_L48P_HDC_M1DQ8_1)
EPDC_D2: RN2.8 (R1.2), U5.R16 (IO_L49N_M1DQ11_1)
EPDC_D3: RN3.5 (R4.2), U5.R15 (IO_L49P_M1DQ10_1)
EPDC_D4: RN3.6 (R3.2), U5.T15 (IO_L50N_M1UDQSN_1)
EPDC_D5: RN3.7 (R2.2), U5.T14 (IO_L51P_M1DQ12_1)
EPDC_D6: RN3.8 (R1.2), U5.T13 (IO_L51N_M1DQ13_1)
EPDC_D7: RN4.5 (R4.2), U5.R12 (IO_L52P_M1DQ14_1)
EPDC_D8: RN4.6 (R3.2), U5.T12 (IO_L52N_M1DQ15_1)
EPDC_D9: RN4.7 (R2.2), U5.K16 (IO_L44N_A2_M1DQ7_1)
EPDC_D10: RN4.8 (R1.2), U5.K14 (IO_L41N_GCLK8_M1CASN_1)
EPDC_D11: RN5.5 (R4.2), U5.K15 (IO_L44P_A3_M1DQ6_1)
EPDC_D12: RN5.6 (R3.2), U5.L16 (IO_L47N_LDC_M1DQ1_1)
EPDC_D13: RN5.7 (R2.2), U5.M15 (IO_L46P_FCS_B_M1DQ2_1)
EPDC_D14: RN5.8 (R1.2), U5.M16 (IO_L46N_FOE_B_M1DQ3_1)
EPDC_D15: RN6.5 (R4.2), U5.N16 (IO_L45N_A0_M1LDQSN_1)
EPDC_GDCLK: RN1.7 (R2.2), U5.H16 (IO_L37N_A6_M1A1_1)
EPDC_GDOE: RN1.6 (R3.2), U5.G16 (IO_L36N_A8_M1BA1_1)
EPDC_GDSP: RN1.8 (R1.2), U5.J16 (IO_L43N_GCLK4_M1DQ5_1)
EPDC_SDCE0: RN6.6 (R3.2), U5.L14 (IO_L47P_FWE_B_M1DQ0_1)
EPDC_SDCLK: RN2.5 (R4.2), U5.N14 (IO_L45P_A1_M1LDQS_1)
EPDC_SDLE: RN6.7 (R2.2), U5.M14 (IO_L74N_DOUT_BUSY_1)
EPDC_SDOE: RN6.8 (R1.2), U5.R14 (IO_L50P_M1UDQS_1)
EPD_PWR_EN: U6.4 (EN), U14.32 (GPIO21)
EPD_VCOM_PWM: D5.1 (K), R27.2, U14.34 (GPIO22)
FPGA_CS: U5.L10 (IO_L16P_2), U14.16 (GPIO13)
FPGA_DONE: R15.2, U5.P13 (DONE_2), U14.29 (GPIO18)
FPGA_MISO: U5.T10 (IO_L3N_MOSI_CSI_B_MISO0_2), U14.15 (GPIO12)
FPGA_MOSI: U5.P10 (IO_L3P_D0_DIN_MISO_MISO1_2), U14.18 (GPIO15)
FPGA_PROG: R13.2, U5.T2 (PROGRAM_B_2), U14.28 (GPIO17)
FPGA_SCLK: U5.R11 (IO_L1P_CCLK_2), U14.17 (GPIO14)
FPGA_SUSP: R14.1, U5.P14 (SUSPEND), U14.30 (GPIO19)
GCLK: R11.1, U5.N8 (IO_L29N_GCLK2_2)
GND: C1.1, C2.1, C3.1, C4.1, C5.1, C6.1, C14.1, C15.1, C16.1, C17.1, C18.2, C19.2, C20.2, C21.2, C22.2, C23.2, C24.2, C25.2, C26.2, C27.2, C28.2, C29.2, C30.1, C31.1, C32.1, C37.1, C38.2, C39.2, C42.1, C43.1, C44.1, C45.1, C46.2, C47.2, C48.1, C49.1, C50.2, C51.1, C52.1, C53.1, C54.1, C56.1, C57.2, C58.2, C59.2, C60.2, C61.2, C62.2, C63.2, C64.2, C65.2, C66.2, C67.2, C68.2, C69.2, C70.2, C71.2, C72.2, C73.2, C74.2, C75.2, C76.2, C77.2, C78.2, C79.2, C80.2, C81.2, C82.2, C83.2, C84.2, C85.2, C86.2, C88.2, C89.2, C90.2, C91.2, C92.2, C93.2, C94.2, C95.2, C96.2, C97.2, C98.2, C99.2, C100.2, C101.2, C102.2, C103.1, C104.1, C113.2, C114.2, C115.2, C116.2, C117.2, C118.2, C119.2, C120.2, C121.2, C122.2, C123.2, C124.2, C125.2, C126.2, C127.2, C128.2, C129.2, C130.2, C131.2, C132.2, C133.2, C134.2, C135.2, C136.2, C137.2, C138.2, C139.2, C140.2, C141.2, C142.2, C143.2, C144.2, C145.2, C146.2, C147.2, C148.2, C149.2, C150.2, C151.1, C152.1, C155.1, D3.1 (K), D4.1 (K), D5.2 (A), D9.3 (GND), D9.8 (GND), D10.3 (GND), D10.8 (GND), D11.3 (GND), D11.8 (GND), D12.3 (GND), D12.8 (GND), D13.3 (GND), D13.8 (GND), J1.A1 (GND), J1.A12 (GND), J1.B1 (GND), J1.B12 (GND), J1.S1 (SHIELD), J3.9, J3.12, J3.22, J3.MP (MountPin), J4.2 (D2S), J4.5 (D1S), J4.8 (D0S), J4.11 (CKS), J4.17 (GND), J4.SH, J5.2, J5.MP (MountPin), L6.2, L7.2, Q2.2 (E), R1.1, R2.1, R4.1, R6.1, R8.1, R9.1, R14.2, R17.1, R18.2, R20.2, R23.1, R25.1, R29.1, R37.2, R38.2, R40.2, R41.2, R42.2, R44.2, R48.1, SW1.2, SW2.2, U1.2 (GND), U2.2 (GND), U3.2 (GND), U4.2 (GND), U5.A1 (GND), U5.A16 (GND), U5.B7 (GND), U5.B11 (GND), U5.D4 (GND), U5.D13 (GND), U5.E9 (GND), U5.G2 (GND), U5.G8 (GND), U5.G15 (GND), U5.H7 (GND), U5.H9 (GND), U5.H12 (GND), U5.J5 (GND), U5.J8 (GND), U5.K7 (GND), U5.K9 (GND), U5.L2 (GND), U5.L15 (GND), U5.M8 (GND), U5.N13 (GND), U5.P3 (GND), U5.R6 (GND), U5.R10 (GND), U5.T1 (GND), U5.T16 (GND), U6.2 (GND), U7.2 (GND), U8.2 (GND), U11.5 (V+), U12.A9 (VSS), U12.B1 (VSSQ), U12.B3 (VSS), U12.B9 (VSSQ), U12.D1 (VSSQ), U12.D8 (VSSQ), U12.E1 (VSS), U12.E2 (VSSQ), U12.E8 (VSSQ), U12.F9 (VSSQ), U12.G1 (VSSQ), U12.G8 (VSS), U12.G9 (VSSQ), U12.J1 (VSS), U12.J2 (VSS), U12.J8 (VSS), U12.J9 (VSS), U12.L1 (VSS), U12.L9 (VSS), U12.M1 (VSS), U12.M9 (VSS), U12.P1 (VSS), U12.P9 (VSS), U12.T1 (VSS), U12.T9 (VSS), U13.4 (GND), U13.9 (EP), U14.19 (TESTEN), U14.57 (GND), U15.65 (GND), U16.2 (GND), U17.8 (GND), U17.9 (GND), U17.12 (VCONN), U17.13 (VCONN), U17.15 (GND), U18.2 (XSD), U18.5 (GND), U18.11 (GND), U18.20 (GND), U18.21 (GND), U19.3 (GND), U19.17 (GNDREG), U19.18 (GNDREG), U19.56 (EPS_N), U19.57 (EP), U20.2 (GND), Y1.2 (GND), Y2.2, Y2.4, Y3.2, Y3.4
I2C_SCL: U14.5 (GPIO3), U15.54 (SDA), U17.6 (SCL), U19.25 (MS_SCL)
I2C_SDA: U14.4 (GPIO2), U15.53 (SCL), U17.7 (SDA), U19.24 (MS_SDA)
KEY: SW2.1, U14.8 (GPIO6)
KEY2: SW1.1, U14.7 (GPIO5)
LVDS_EVEN_AN: U5.D11 (IO_L66P_SCP1_0), U19.42 (LVSAE_N)
LVDS_EVEN_AP: U5.D12 (IO_L66N_SCP0_0), U19.41 (LVSAE_P)
LVDS_EVEN_BN: U5.C13 (IO_L63P_SCP7_0), U19.40 (LVSBE_N)
LVDS_EVEN_BP: U5.A13 (IO_L63N_SCP6_0), U19.39 (LVSBE_P)
LVDS_EVEN_CN: U5.A14 (IO_L65N_SCP2_0), U19.37 (LVSCE_N)
LVDS_EVEN_CP: U5.B14 (IO_L65P_SCP3_0), U19.36 (LVSCE_P)
LVDS_ODD_AN: U5.E7 (IO_L36P_GCLK15_0), U19.54 (LVSAO_N)
LVDS_ODD_AP: U5.E8 (IO_L36N_GCLK14_0), U19.53 (LVSAO_P)
LVDS_ODD_BN: U5.B8 (IO_L33P_0), U19.52 (LVSBO_N)
LVDS_ODD_BP: U5.A8 (IO_L33N_0), U19.51 (LVSBO_P)
LVDS_ODD_CKN: U5.B10 (IO_L35P_GCLK17_0), U19.47 (LVSCKO_N)
LVDS_ODD_CKP: U5.A10 (IO_L35N_GCLK16_0), U19.46 (LVSCKO_P)
LVDS_ODD_CN: U5.D9 (IO_L40N_0), U19.49 (LVSCO_N)
LVDS_ODD_CP: U5.F9 (IO_L40P_0), U19.48 (LVSCO_P)
unnamed: C93.1, R57.2, Y2.3
unnamed: C117.1, C120.1, C123.1, FB1.2, U19.13 (VDD33), U19.14 (VDD33)
unnamed: C118.1, C121.1, C124.1, FB2.2, U19.38 (VDD33), U19.50 (VDD33)
unnamed: D1.2 (A), L4.2, U7.1 (SW)
unnamed: D2.2 (A), L5.2, U8.1 (SW)
unnamed: D7.2 (A), D8.2 (A), Q1.3 (D)
unnamed: D7.1 (K), R31.2
unnamed: D8.1 (K), R32.2
unnamed: Q1.1 (G), Q2.3 (C), R28.1
unnamed: Q2.1 (B), R29.2, R30.2
unnamed: Q6.1 (G), Q7.3 (D), R62.1
unnamed: Q6.2 (S), U11.3 (-), U11.4
unnamed: Q7.1 (G), R63.2
unnamed: Q8.3 (D), R64.1
unnamed: Q8.1 (G), R66.1
unnamed: C8.2, U1.1 (BS)
unnamed: C11.1, R3.1, R4.2, U1.3 (FB)
unnamed: C8.1, L1.1, U1.6 (SW)
unnamed: C9.2, U2.1 (BS)
unnamed: C12.1, R5.1, R6.2, U2.3 (FB)
unnamed: C9.1, L2.1, U2.6 (SW)
unnamed: C10.2, U3.1 (BS)
unnamed: C13.1, R7.1, R8.2, U3.3 (FB)
unnamed: C10.1, L3.1, U3.6 (SW)
unnamed: R9.2, U4.3 (SET)
unnamed: R35.2, U5.T11 (IO_L1N_M0_CMPMISO_2)
unnamed: R37.1, U5.M4 (IO_L1P_3)
unnamed: R36.2, U5.N11 (IO_L13P_M1_2)
unnamed: R17.2, U6.3 (SET)
unnamed: C40.1, R22.1, R23.2, U7.3 (NFB)
unnamed: C41.1, R24.1, R25.2, U8.3 (NFB)
unnamed: C35.2, U9.1 (BS)
unnamed: C38.1, R18.1, R19.2, U9.3 (FB)
unnamed: C35.1, L6.1, U9.6 (SW)
unnamed: C36.2, U10.1 (BS)
unnamed: C39.1, R20.1, R21.2, U10.3 (FB)
unnamed: C36.1, L7.1, U10.6 (SW)
unnamed: C52.2, R26.2, R27.1, U11.1 (+)
unnamed: R41.1, U12.L8 (ZQ)
unnamed: R59.2, U14.46 (USB_DM)
unnamed: R58.2, U14.47 (USB_DP)
unnamed: C125.1, R45.1, U15.59 (XTALN), Y3.3
unnamed: C113.1, R45.2, U15.58 (XTALP), Y3.1
unnamed: R2.2, U19.20 (TESTMODE)
unnamed: C153.2, U20.1 (BS)
unnamed: C154.1, R10.1, R48.2, U20.3 (FB)
unnamed: C153.1, L8.1, U20.6 (SW)
unnamed: R12.2, Y1.1 (EN)
unnamed: R11.2, Y1.3 (OUT)
TCPC_INT: U14.14 (GPIO11), U17.5 (INT_N)
TYPEC_ORI: U14.13 (GPIO10), U18.9 (SEL)
USB_DN: J1.A7 (D-), J1.B7 (D-), R59.1, U16.3 (I/O2), U16.4 (I/O2)
USB_DP: J1.A6 (D+), J1.B6 (D+), R58.1, U16.1 (I/O1), U16.6 (I/O1)
VBUS: C104.2, J1.A4 (VBUS), J1.A9 (VBUS), J1.B4 (VBUS), J1.B9 (VBUS), U4.4 (EN), U4.5 (VIN), U6.5 (VIN), U16.5 (VBUS), U17.2 (VBUS)
VCOM: C56.2, C60.1, J3.10, J3.40, Q6.3 (D), R64.2
VCOM_EN: R63.1, U14.40 (GPIO28_ADC2)
VCOM_MEA: Q8.2 (S), R65.2, U14.39 (GPIO27_ADC1)
VCOM_MEA_EN: R66.2, U14.38 (GPIO26_ADC0)
VGH: C41.2, C44.2, C62.1, D2.1 (K), J3.3, R24.2
VGL: C33.1, C46.1, C63.1, D3.2 (A), D6.2 (A), J3.1, R19.1, R33.1, U9.2 (GND)
VNEG: C34.1, C47.1, C50.1, C54.2, D4.2 (A), D6.1 (K), J3.38, R21.1, R26.1, R34.1, R62.2, U10.2 (GND), U11.2 (V-)
VPOS: C40.2, C43.2, C48.2, D1.1 (K), J3.36, R22.2
