Modos-Labs/Glider/pcb/50p-adapter-b/adapter.kicad_pcb

## KiCad design pcb/50p-adapter-b/adapter.kicad_pcb (2024-05-03, an earlier design)

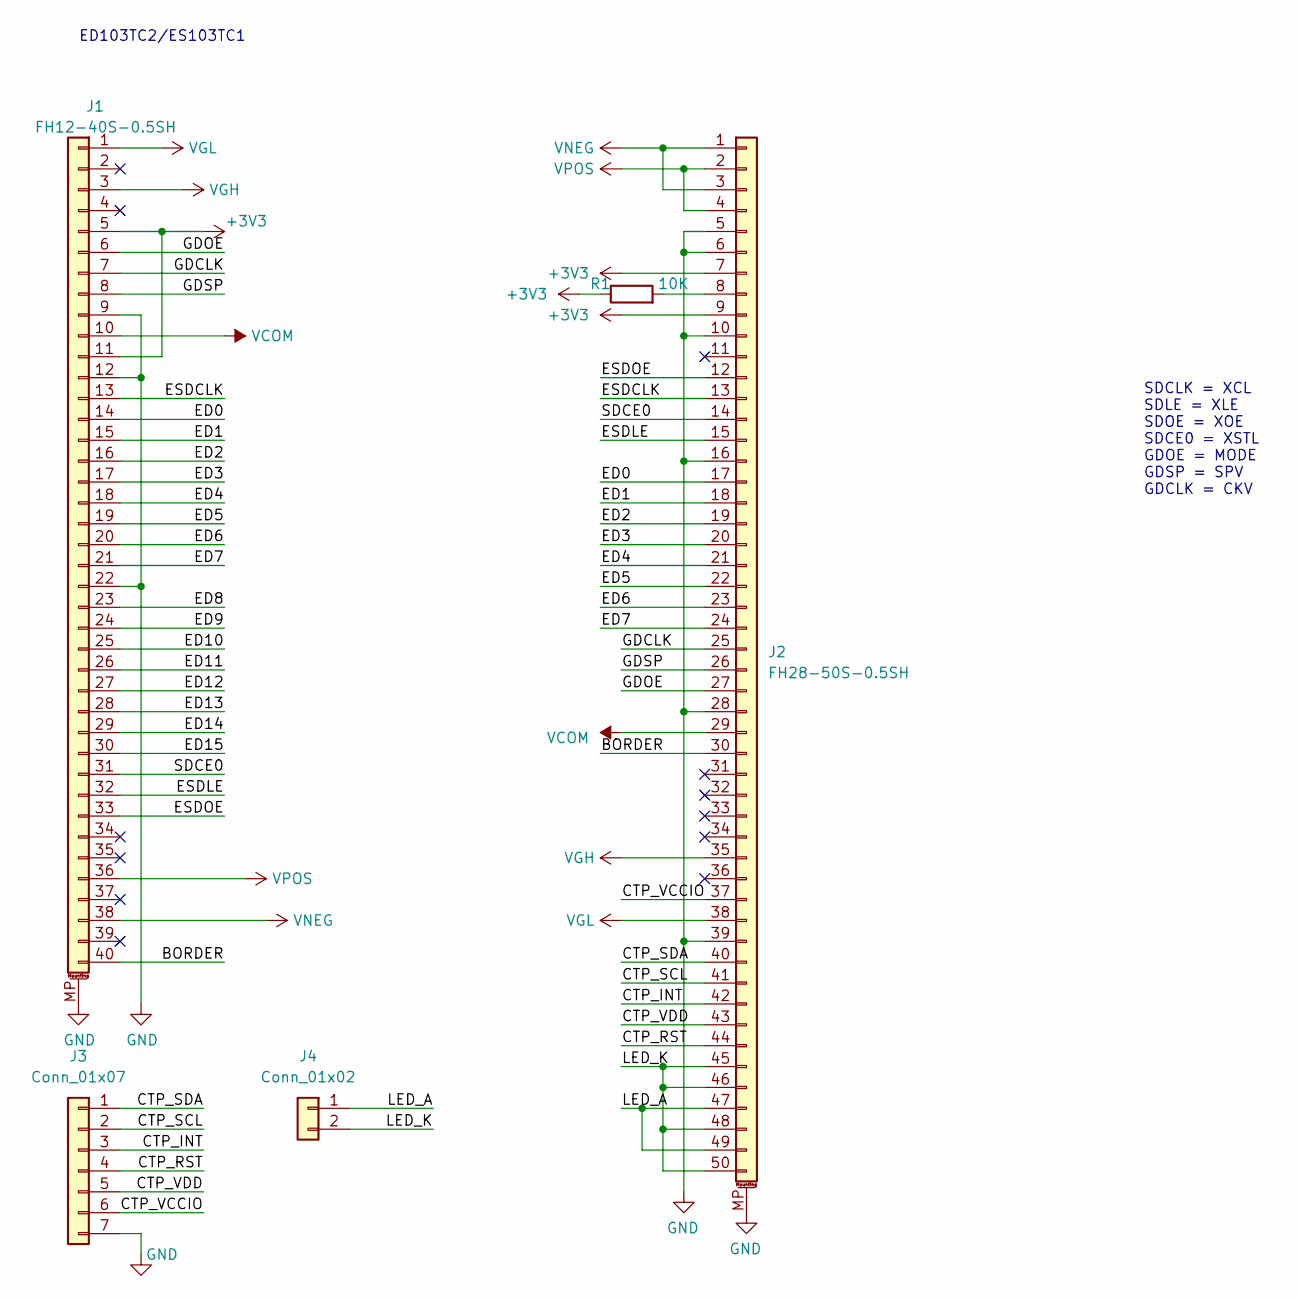
[picture p46: schematic adapter.kicad_sch]

Parts:
J1: FH12-40S-0.5SH; Hirose_FH12-40S-0.5SH_1x40-1MP_P0.50mm_Horizontal_Reversed
J2: FH28-50S-0.5SH; BM20B-0.8-50
J3: Conn_01x07; PinHeader_1x07_P2.54mm_Vertical
J4: Conn_01x02; PinHeader_1x02_P2.54mm_Vertical
R1: 10K; R_0402_1005Metric

Connections:
+3V3: J1.5, J1.11, J2.7, J2.9, R1.1
/BORDER: J1.40, J2.30
/CTP_INT: J2.42, J3.3
/CTP_RST: J2.44, J3.4
/CTP_SCL: J2.41, J3.2
/CTP_SDA: J2.40, J3.1
/CTP_VCCIO: J2.37, J3.6
/CTP_VDD: J2.43, J3.5
/ED0: J1.14, J2.17
/ED1: J1.15, J2.18
/ED2: J1.16, J2.19
/ED3: J1.17, J2.20
/ED4: J1.18, J2.21
/ED5: J1.19, J2.22
/ED6: J1.20, J2.23
/ED7: J1.21, J2.24
/ED8: J1.23
/ED9: J1.24
/ED10: J1.25
/ED11: J1.26
/ED12: J1.27
/ED13: J1.28
/ED14: J1.29
/ED15: J1.30
/ESDCLK: J1.13, J2.13
/ESDLE: J1.32, J2.15
/ESDOE: J1.33, J2.12
/GDCLK: J1.7, J2.25
/GDOE: J1.6, J2.27
/GDSP: J1.8, J2.26
/LED_A: J2.47, J2.49, J4.1
/LED_K: J2.45, J2.46, J2.48, J2.50, J4.2
/SDCE0: J1.31, J2.14
GND: J1.9, J1.12, J1.22, J1.MP (MountPin), J2.5, J2.6, J2.10, J2.16, J2.28, J2.39, J2.MP (MountPin), J3.7
unnamed: J2.8, R1.2
VCOM: J1.10, J2.29
VGH: J1.3, J2.35
VGL: J1.1, J2.38
VNEG: J1.38, J2.1, J2.3
VPOS: J1.36, J2.2, J2.4

Notes on the sheet:
SDCLK = XCL SDLE = XLE SDOE = XOE SDCE0 = XSTL GDOE = MODE GDSP = SPV GDCLK = CKV
ED103TC2/ES103TC1

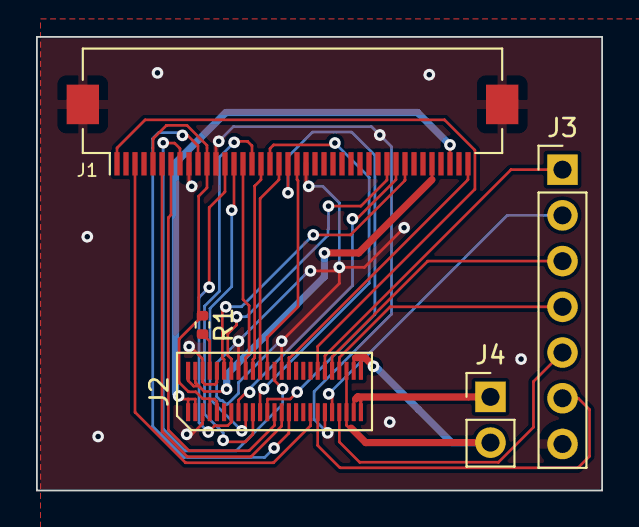
[picture p47: board pcb/50p-adapter-b/adapter.kicad_pcb from above]

Board: 2 copper layers, 31.4 x 25.2 mm, 5 parts (0 on the bottom side), 32 nets.
