Modos-Labs/Glider/pcb/39p-adapter-c/adapter.kicad_pcb

## KiCad design pcb/39p-adapter-c/adapter.kicad_pcb (2024-05-03, an earlier design)

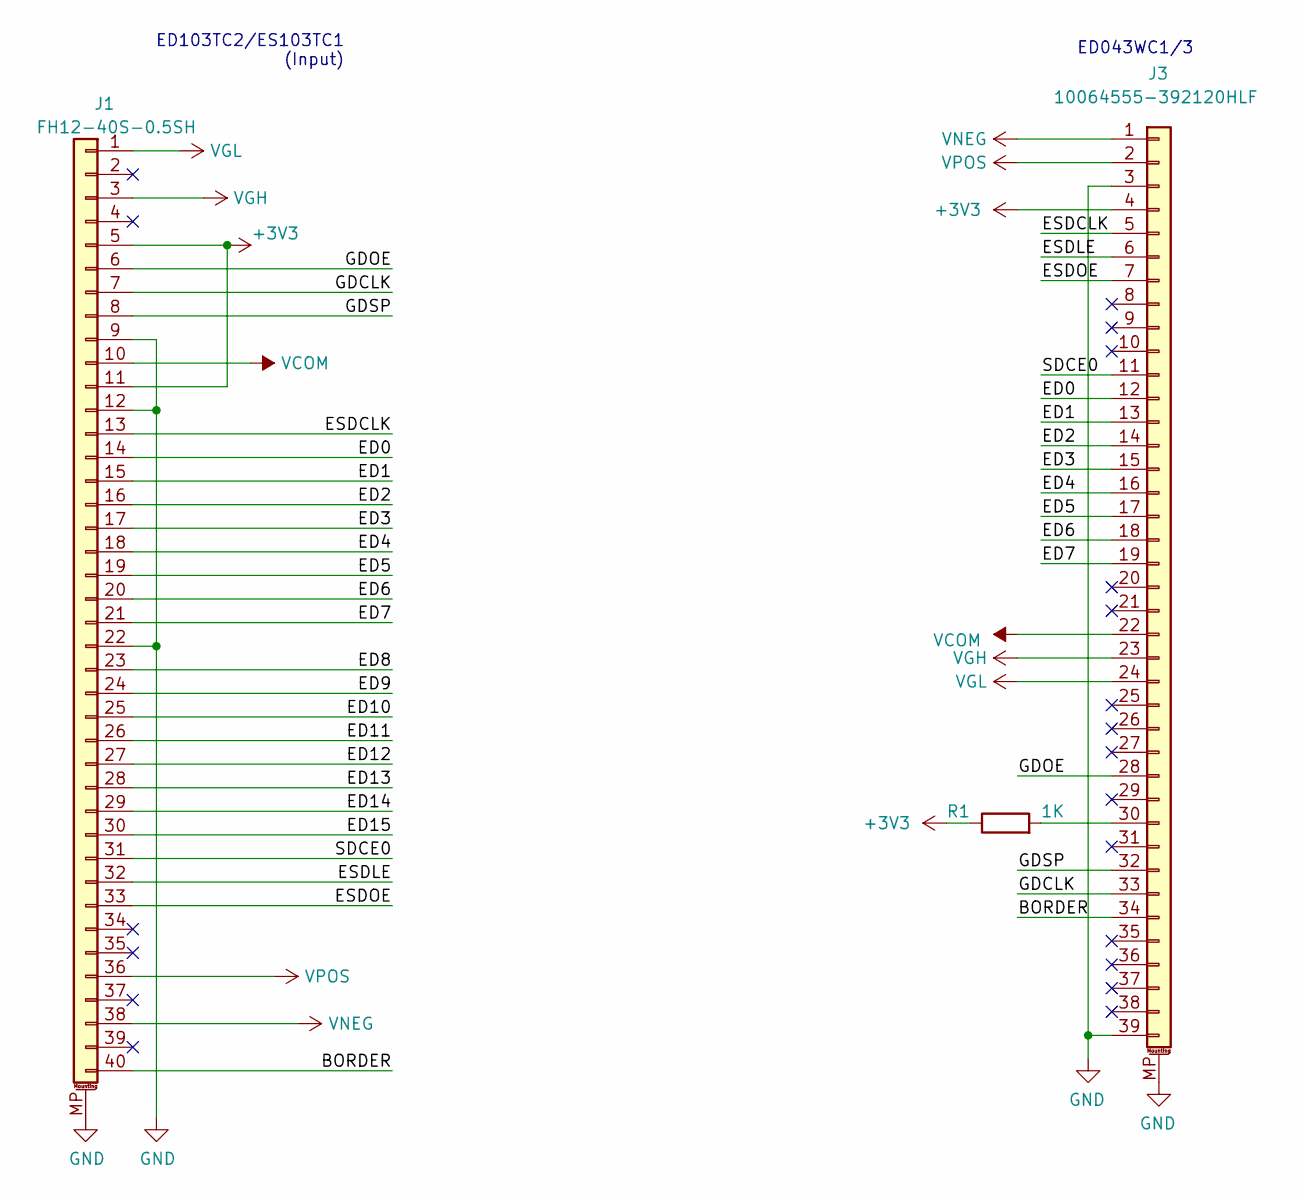
[picture p48: schematic adapter.kicad_sch]

Parts:
J1: FH12-40S-0.5SH; Hirose_FH12-40S-0.5SH_1x40-1MP_P0.50mm_Horizontal_Reversed
J3: 10064555-392120HLF; HRS_FH26W-39S-0.3SHW(60); LCSC 609-10064555-392120HLFCT-ND
R1: 1K; R_0603_1608Metric

Connections:
+3V3: J1.5, J1.11, J3.4, R1.1
/BORDER: J1.40, J3.34
/ED0: J1.14, J3.12
/ED1: J1.15, J3.13
/ED2: J1.16, J3.14
/ED3: J1.17, J3.15
/ED4: J1.18, J3.16
/ED5: J1.19, J3.17
/ED6: J1.20, J3.18
/ED7: J1.21, J3.19
/ED8: J1.23
/ED9: J1.24
/ED10: J1.25
/ED11: J1.26
/ED12: J1.27
/ED13: J1.28
/ED14: J1.29
/ED15: J1.30
/ESDCLK: J1.13, J3.5
/ESDLE: J1.32, J3.6
/ESDOE: J1.33, J3.7
/GDCLK: J1.7, J3.33
/GDOE: J1.6, J3.28
/GDSP: J1.8, J3.32
/SDCE0: J1.31, J3.11
GND: J1.9, J1.12, J1.22, J1.MP (MountPin), J3.3, J3.39, J3.MP (MountPin)
unnamed: J3.30, R1.2
VCOM: J1.10, J3.22
VGH: J1.3, J3.23
VGL: J1.1, J3.24
VNEG: J1.38, J3.1
VPOS: J1.36, J3.2

Notes on the sheet:
ED103TC2/ES103TC1 (Input)
ED043WC1/3

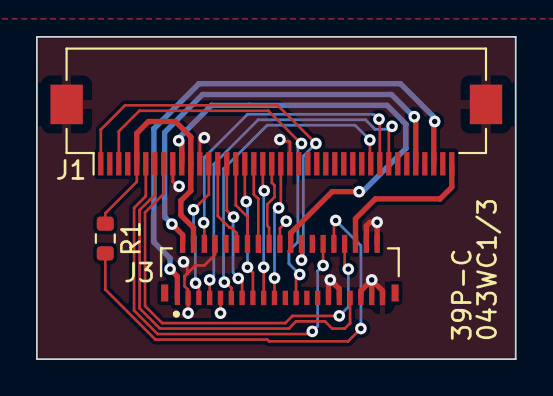
[picture p49: board pcb/39p-adapter-c/adapter.kicad_pcb from above]

Board: 2 copper layers, 26.6 x 17.9 mm, 3 parts (0 on the bottom side), 24 nets.
