Modos-Labs/Glider/(commit log)

2022-03-05 - Initial commit
    [dp_in.kicad_sch, eink.kicad_sch, fpga.kicad_sch, fpga_ddr.kicad_sch, pcb.kicad_pcb, pcb.kicad_sch, power.kicad_sch]
2022-07-04 pcb: r0p4
    [dp_in.kicad_sch, eink.kicad_sch, fpga.kicad_sch, fpga_ddr.kicad_sch, mcu.kicad_sch, pcb.kicad_pcb, pcb.kicad_sch, power.kicad_sch]
2022-07-04 pcb: 39p adapter for ed133/es133ut screens
    [adapter.kicad_pcb, adapter.kicad_sch]
2022-11-21 pcb: r0p5
    [dp_in.kicad_sch, eink.kicad_sch, fpga.kicad_sch, fpga_ddr.kicad_sch, mcu.kicad_sch, pcb.kicad_pcb, pcb.kicad_sch]
2023-03-04 fw: power, fpga handling, fix ptn3460 params
    [edid.h, fpga.c, fpga.h, ptn3460.c]
2023-06-26 pcb: r0p6
    [dp_in.kicad_sch, eink.kicad_sch, fpga.kicad_sch, fpga_ddr.kicad_sch, mcu.kicad_sch, pcb.kicad_pcb, pcb.kicad_sch, power.kicad_sch]
2023-12-08 Add GPIO controlled power supply support
2023-12-27 Initial design of lite version
    [dp_in.kicad_sch, eink.kicad_sch, fpga.kicad_sch, fpga_ddr.kicad_sch, pcb.kicad_pcb, pcb.kicad_sch, power.kicad_sch]
2023-12-27 Lite version r0p1
    [dp_in.kicad_sch, eink.kicad_sch, fpga.kicad_sch, fpga_ddr.kicad_sch, mcu.kicad_sch, pcb.kicad_pcb, pcb.kicad_sch, power.kicad_sch]
2024-01-10 Fix PCB thickness; add initial case design for lite version
    [case.FCStd, pcb.kicad_pcb]
2024-01-16 Fix missing features bitmap in EDID
    [edid.c]
2024-01-26 r0p7 wip, check in before switch to kicad 8
    [dp_in.kicad_sch, eink.kicad_sch, fpga.kicad_sch, fpga_ddr.kicad_sch, mcu.kicad_sch, pcb.kicad_pcb, pcb.kicad_sch, power.kicad_sch]
2024-02-01 r0p7 wip
    [dp_in.kicad_sch, eink.kicad_sch, fpga.kicad_sch, fpga_ddr.kicad_sch, mcu.kicad_sch, pcb.kicad_pcb, pcb.kicad_sch, power.kicad_sch]
2024-02-12 r0p7 layout done
    [dp_in.kicad_sch, eink.kicad_sch, fpga.kicad_sch, fpga_ddr.kicad_sch, mcu.kicad_sch, pcb.kicad_pcb, power.kicad_sch, tmds_in.kicad_sch]
2024-02-12 lite r0p1 schematic fixes
    [eink.kicad_sch, mcu.kicad_sch, pcb.kicad_sch]
2024-02-13 Fix NPTH clearance issue
    [pcb.kicad_pcb]
2024-04-02 Add adapter for ED067KC1/ED113TC1; revise mainboard connector model
    [adapter.kicad_pcb, adapter.kicad_sch, dp_in.kicad_sch, tmds_in.kicad_sch]
2024-04-30 Initial driver support for ADV7611
2024-05-03 Fix PD for r0p7; Add config for 11.3 panel
    [config.h]
2024-05-03 Rename old 39p adapter to 39p-a; Add 39p-c adapter
    [adapter.kicad_pcb, adapter.kicad_sch]
2024-05-10 Bug fixes and changes for r0p8
    [dp_in.kicad_sch, eink.kicad_sch, fpga.kicad_sch, fpga_ddr.kicad_sch, mcu.kicad_sch, pcb.kicad_sch, power.kicad_sch, tmds_in.kicad_sch]
2024-05-10 New adapters WIP
    [adapter.kicad_pcb, adapter.kicad_sch]
2024-05-25 Update adapters
    [adapter.kicad_pcb, adapter.kicad_sch]
2024-05-25 PCB r0p8
    [dp_in.kicad_sch, eink.kicad_sch, fpga.kicad_sch, fpga_ddr.kicad_sch, mcu.kicad_sch, pcb.kicad_pcb, pcb.kicad_sch, power.kicad_sch]
2024-07-04 BOM adjustments
    [dp_in.kicad_sch, eink.kicad_sch, fpga.kicad_sch, fpga_ddr.kicad_sch, mcu.kicad_sch, pcb.kicad_pcb, pcb.kicad_sch, power.kicad_sch]
2024-07-04 Update 39p-b adapter design
    [adapter.kicad_pcb]
2024-09-22 R0P9 PCB WIP
    [dp_in.kicad_sch, epd.kicad_sch, epd_power.kicad_sch, fpga.kicad_sch, fpga_ddr.kicad_sch, mcu.kicad_sch, pcb.kicad_sch, power.kicad_sch]
2024-11-19 Switch to use pcb_common submodule
    [pcb.kicad_pcb]
2024-11-19 PCB r0p9
    [dp_in.kicad_sch, epd.kicad_sch, epd_power.kicad_sch, fpga.kicad_sch, fpga_config.kicad_sch, fpga_ddr.kicad_sch, fpga_io.kicad_sch, mcu.kicad_sch]
2024-12-17 PCB r0p10 wip
    [dp_in.kicad_sch, epd.kicad_sch, epd_power.kicad_sch, fpga_config.kicad_sch, fpga_ddr.kicad_sch, fpga_io.kicad_sch, mcu.kicad_sch, pcb.kicad_sch]
2025-02-22 PCB r0p10
    [dp_in.kicad_sch, epd.kicad_sch, epd_power.kicad_sch, fpga_config.kicad_sch, fpga_ddr.kicad_sch, fpga_io.kicad_sch, mcu.kicad_sch, pcb.kicad_sch]
2025-04-15 New firmware for STM32 based controller
2025-04-25 PCB r0p11
    [epd.kicad_sch, epd_power.kicad_sch, fpga_io.kicad_sch, power.kicad_sch, power_mon.kicad_sch]
2025-04-25 Remove outdated boards
    [adapter.kicad_pcb, adapter.kicad_sch, dp_in.kicad_sch, eink.kicad_sch, fpga.kicad_sch, fpga_ddr.kicad_sch, mcu.kicad_sch, pcb.kicad_pcb]
2025-04-25 PCB r0p13
    [dp_in.kicad_sch, eink.kicad_sch, epd.kicad_sch, epd_power.kicad_sch, fpga.kicad_sch, fpga_config.kicad_sch, fpga_ddr.kicad_sch, fpga_io.kicad_sch]
2025-05-19 Enable power monitoring
2025-06-26 PCB r1.1
    [dp_in.kicad_sch, epd.kicad_sch, epd_power.kicad_sch, fpga_config.kicad_sch, fpga_ddr.kicad_sch, fpga_io.kicad_sch, mcu.kicad_sch, pcb.kicad_sch]
2025-07-13 Add u133 adapter
    [adapter.kicad_pcb, adapter.kicad_sch]
2025-08-06 PCB r1.2, new adapters
    [adapter.kicad_pcb, adapter.kicad_sch, epd_power.kicad_sch, mcu.kicad_sch]
2025-08-06 Implement power up sequence check
2025-08-14 Add more fail-safe protections; Change USB block size to 64
    [power.c, shell.c, shell_cmds.c, syslog.c, syslog.h, tusb_config.h, ui.c, usbapp.c]
