Modos-Labs/Glider/(notices)

Notices in the files:
utils/mxc_waveform_asm/main.c:
This is free software: you can redistribute it and/or modify it under the
terms of the GNU General Public License as published by the Free Software
fw/Core/Src/main.c:
Copyright (c) 2025 STMicroelectronics.
All rights reserved.
This software is licensed under terms that can be found in the LICENSE file
pcb/mainboard/mcu.kicad_sch:
Copyright 2022 Modos / Engineer: Wenting Zhang
pcb/mainboard/pcb.kicad_sch:
Copyright 2023 Modos / Engineer: Wenting Zhang
